UA-Robotics/UA-NASA-Robotic-Mining-2012-Hardware/Main Board V4.0/eagleUp/eagleUp_Main board V4.0_imagesize.png

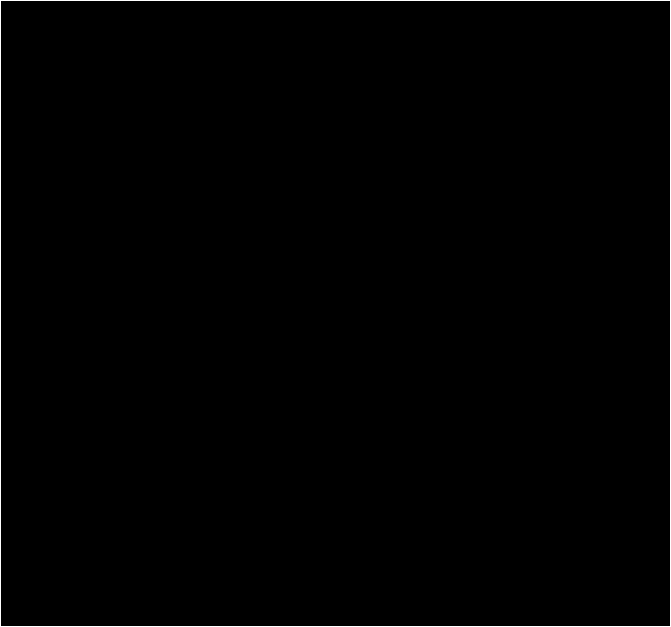
Main Board V4.0/eagleUp/eagleUp_Main board V4.0_imagesize.png
