UA-Robotics/UA-NASA-Robotic-Mining-2012-Hardware/Motor Control/eagleUp/eagleUp_Motor Control_board_top.png

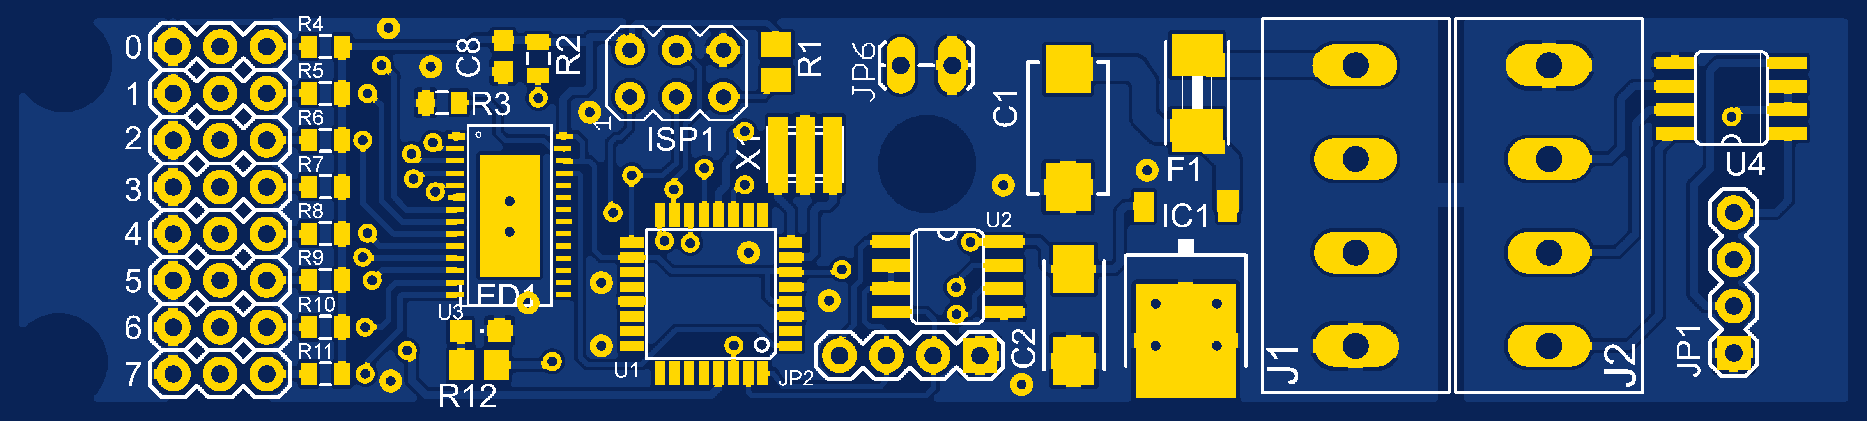
Motor Control/eagleUp/eagleUp_Motor Control_board_top.png
