UA-Robotics/UA-NASA-Robotic-Mining-2012-Hardware/Motor Control/eagleUp/eagleUp_Motor Control_bottom.png

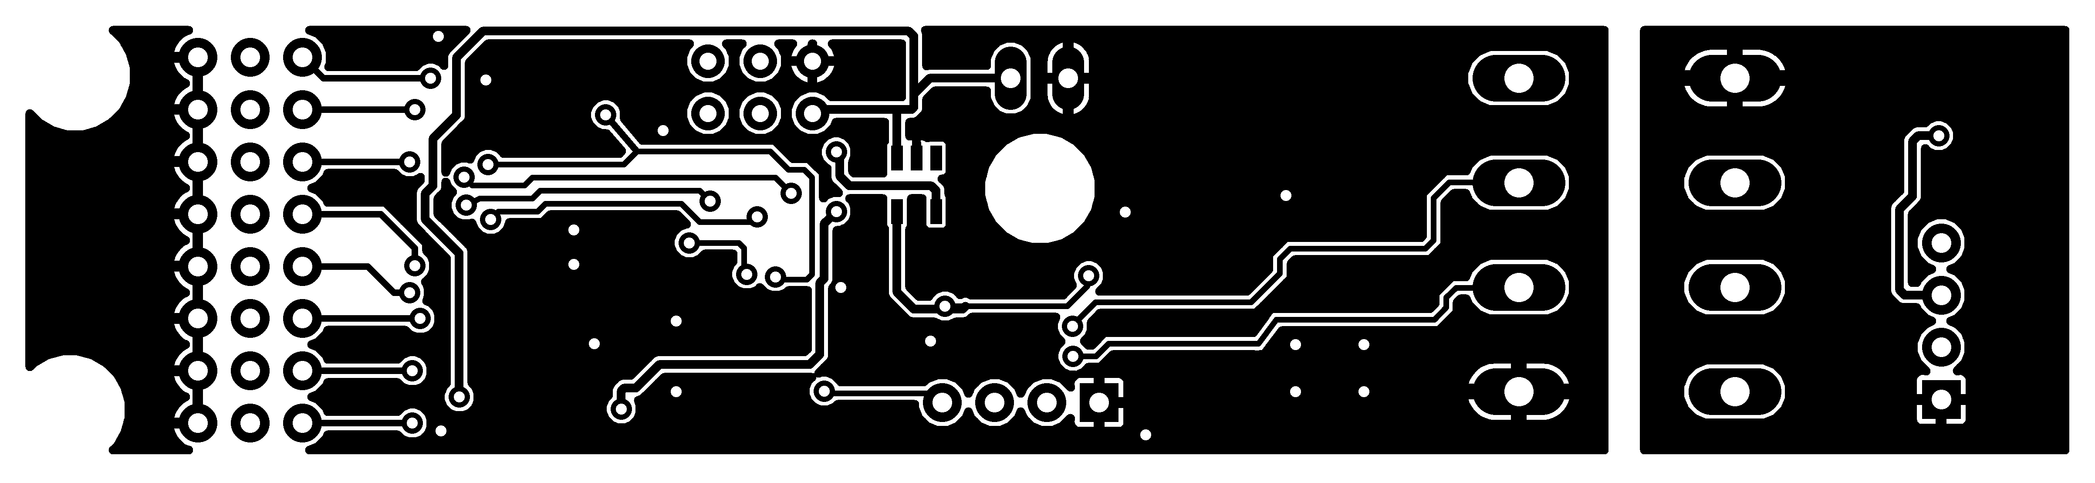
Motor Control/eagleUp/eagleUp_Motor Control_bottom.png
