UA-Robotics/UA-NASA-Robotic-Mining-2012-Hardware/Ext. Sens Board/nasa bot parts list per PCB.xlsx

 |  |  | ECE PARTS REQUEST ORDERING FORM
 |  | Student Name: | Richard Johnson | Email:
 |  | Project Name: | NASA Bot |  | Date Submitted:
 | Faculty Advisor Approval: |  |  |  | Date Ordered:
 |  | Email the completed form to: | glewis@uakron.edu |  | Ordered By:
 |  |  |  |  |  |  | Unit | Total
Qty. | Refdes | Part Num. | Description | Suggested Vendor | Vendor Part Num. | Catalog #/Page #/Website | Cost | Cost
2 |  | SK34B-TP | DIODE SCHOTTKY 3A 40V SMB | Digi-Key | SK34B-TPCT-ND | http://search.digikey.com/us/en/products/SK34B-TP/SK34B-TPCT-ND/950519 | 0.61 | 1.22
 |  |  |  |  |  |  |  | 0.00
 |  |  |  |  |  |  |  | 0.00
1 |  | MAX4080TASA | IC AMP CURRENT SENSE 8-SOIC | Digi-Key | MAX4080TASA+-ND | http://search.digikey.com/scripts/DkSearch/dksus.dll?Detail&name=MAX4080TASA%2B-ND | 2.78 | 2.78
 |  |  |  |  |  |  |  | 0.00
 |  |  |  |  |  |  |  | 0.00
 |  |  |  |  |  |  |  | 0.00
1 |  | ATMEGA1280-16AU | IC MCU AVR 128K FLASH 100-TQFP | Digi-Key | ATMEGA1280-16AU-ND | http://search.digikey.com/scripts/DkSearch/dksus.dll?Detail&name=ATMEGA1280-16AU-ND | 16.13 | 16.13
17 |  | ERJ-P06J103V | RES 10K OHM 5% 0805 | Digi-Key | P10KADCT-ND | http://search.digikey.com/scripts/DkSearch/dksus.dll?Detail&name=P10KADCT-ND | 0.23 | 3.91
6 |  | ERJ-P06J102V | RES ANTI-SURGE 1K OHM 5% 0805 | Digi-Key | P1.0KADCT-ND | http://search.digikey.com/scripts/DkSearch/dksus.dll?Detail&name=P1.0KADCT-ND | 0.23 | 1.38
 |  |  |  |  |  |  |  | 0.00
1 |  | 961206-6404-AR | CONN HEADER VERT DUAL 6POS GOLD | Digi-Key | 3M9459-ND | http://search.digikey.com/scripts/DkSearch/dksus.dll?Detail&name=3M9459-ND | 0.26 | 0.26
2 |  | FSM4JH | SWITCH TACT 6MM BLACK 160GF | Digi-Key | 450-1650-ND | http://search.digikey.com/scripts/DkSearch/dksus.dll?Detail&name=450-1650-ND | 0.13 | 0.26
2 |  | APT2012SGC | LED 2X1.2MM 568NM GN WTR CLR SMD | Digi-Key | 754-1131-1-ND | http://search.digikey.com/scripts/DkSearch/dksus.dll?Detail&name=754-1131-1-ND | 0.13 | 0.26
2 |  | APT2012EC | LED 2X1.2MM 625NM RD WTR CLR SMD | Digi-Key | 754-1128-1-ND | http://search.digikey.com/scripts/DkSearch/dksus.dll?Detail&name=754-1128-1-ND | 0.13 | 0.26
1 |  | AWSCR-16.00CV-T | RESONATOR CER 16.00MHZ W/CAP SMD | Digi-Key | 535-10008-1-ND | http://search.digikey.com/scripts/DkSearch/dksus.dll?Detail&name=535-10008-1-ND | 0.45 | 0.45
4 |  | 08055A220JAT2A | CAP CERM 22PF 5% 50V NP0 0805 (price per 10 (min 10)) | Digi-Key | 478-1308-1-ND | http://search.digikey.com/scripts/DkSearch/dksus.dll?Detail&name=478-1308-1-ND | 0.083 | 0.33
2 |  | UMK212F105ZG-T | CAP CER 1.0UF 50V Y5V 0805 | Digi-Key | 587-1308-1-ND | http://search.digikey.com/scripts/DkSearch/dksus.dll?Detail&name=587-1308-1-ND | 0.24 | 0.48
4 |  | C3216X5R1H106K | CAP CER 10UF 50V X5R 10% 1206 (price per 1(min 10)) | Digi-Key | 445-5998-1-ND | http://search.digikey.com/scripts/DkSearch/dksus.dll?Detail&name=445-5998-1-ND | 1.98 | 7.92
1 |  | C3216X5R1A107M | CAP CER 100UF 10V X5R 20% 1206 (price per 1(min 10) | Digi-Key | 445-6007-1-ND | http://search.digikey.com/scripts/DkSearch/dksus.dll?Detail&name=445-6007-1-ND | 3.63 | 3.63
4 |  | GRM216F51C104ZA01D | CAP CER .1UF 16V Y5V 0805 (100nf) (price per 1(min 10)) | Digi-Key | 490-1734-1-ND | http://search.digikey.com/scripts/DkSearch/dksus.dll?Detail&name=490-1734-1-ND | 0.076 | 0.30
1 |  | EEF-CX0J101R | CAP 100UF 6.3V SPEC POLYMER SMD(2917 pack) | Digi-Key | PCE4278CT-ND | http://search.digikey.com/scripts/DkSearch/dksus.dll?Detail&name=PCE4278CT-ND | 1.92 | 1.92
1 |  | ERJ-6ENF4702V | RES 47.0K OHM 1/8W 1% 0805 SMD | Digi-Key | P47.0KCCT-ND | http://search.digikey.com/scripts/DkSearch/dksus.dll?Detail&name=P47.0KCCT-ND | 0.07 | 0.07
1 |  | ERJ-6ENF1003V | RES 100K OHM 1/8W 1% 0805 SMD | Digi-Key | P100KCCT-ND | http://search.digikey.com/scripts/DkSearch/dksus.dll?Detail&name=P100KCCT-ND | 0.07 | 0.07
1 |  | ERJ-6ENF6812V | RES 68.1K OHM 1/4W 1% 0805 SMD | Digi-Key | P68.1KCCT-ND | http://search.digikey.com/scripts/DkSearch/dksus.dll?Detail&name=P68.1KCCT-ND | 0.07 | 0.07
1 |  | ERJ-6ENF1182V | RES 11.8K OHM 1/8W 1% 0805 SMD | Digi-Key | P11.8KCCT-ND | http://search.digikey.com/scripts/DkSearch/dksus.dll?Detail&name=P11.8KCCT-ND | 0.04 | 0.04
1 |  | ERJ-6ENF1071V | RES 1.07K OHM 1/8W 1% 0805 SMD | Digi-Key | P1.07KCCT-ND | http://search.digikey.com/scripts/DkSearch/dksus.dll?Detail&name=P1.07KCCT-ND | 0.07 | 0.07
1 |  | ERJ-6ENF5601V | RES 5.60K OHM 1/8W 1% 0805 SMD | Digi-Key | P5.60KCCT-ND | http://search.digikey.com/scripts/DkSearch/dksus.dll?Detail&name=P5.60KCCT-ND | 0.07 | 0.07
2 |  | ERJ-6ENF2201V | RES 2.20K OHM 1/8W 1% 0805 SMD | Digi-Key | P2.20KCCT-ND | http://search.digikey.com/scripts/DkSearch/dksus.dll?Detail&name=P2.20KCCT-ND | 0.07 | 0.14
2 |  | SMAJ60A | DIODE TVS 60V 400W UNI 5% SMA | Digi-Key | SMAJ60ALFCT-ND | http://search.digikey.com/us/en/products/SMAJ60A/SMAJ60ALFCT-ND/762524 |  | 0.00
2 |  | MAL214699113E3 | CAP ALUM 1200UF 50V 20% SMD | Digi-Key | 4446PHCT-ND | http://search.digikey.com/us/en/products/MAL214699113E3/4446PHCT-ND/2410469 |  | 0.00
1 |  | XP1001001-04R | Xport Rev. B11 | Mouser | 515-XP1001001-04R | http://www.mouser.com/Search/ProductDetail.aspx?qs=FyX%252bO5sUg7y%2FaLVJubNUCQ%3D%3D | 49 | 49.00
12 |  | 282825-2 | TERM BLOCK HDR 2POS VERT 5.08MM | Digi-Key | A98321-ND | http://search.digikey.com/scripts/DkSearch/dksus.dll?Detail&name=A98321-ND | 0.39 | 4.68
12 |  | 796634-2 | TERM BLOCK PLUG 2POS 5.08MM | Digi-Key | A98223-ND | http://search.digikey.com/scripts/DkSearch/dksus.dll?Detail&name=A98223-ND | 0.86 | 10.32
2 |  | MAX6818EAP+ | IC DEBOUNCER SWITCH OCTAL 20SSOP | Digi-Key | MAX6818EAP+-ND | http://search.digikey.com/scripts/DkSearch/dksus.dll?Detail&name=MAX6818EAP%2B-ND | 8.6 | 17.20
 |  |  |  |  |  |  |  | 0.00
 |  |  |  |  |  |  |  | 0.00
 |  |  |  |  |  |  |  | 0.00
 |  |  |  |  |  |  | Total | $123.23
