UA-Robotics/UA-NASA-Robotic-Mining-2012-Hardware/Main Board V4.0/Finnal nasa bot parts list per PCB.xlsx

 |  |  | ECE PARTS REQUEST ORDERING FORM
 |  | Student Name: | Richard Johnson | Email: | richcj10@gmail.com
 |  | Project Name: | NASA Bot |  | Date Submitted:
 | Faculty Advisor Approval: |  |  |  | Date Ordered:
 |  | Email the completed form to: | glewis@uakron.edu |  | Ordered By:
 |  |  |  |  |  |  | Unit | Total
Qty. | Refdes | Part Num. | Description | Suggested Vendor | Vendor Part Num. | Catalog #/Page #/Website | Cost | Cost
6 |  | ATMEGA1280-16AU | IC MCU AVR 128K FLASH 100-TQFP | Digi-Key | ATMEGA1280-16AU-ND | http://search.digikey.com/scripts/DkSearch/dksus.dll?Detail&name=ATMEGA1280-16AU-ND | $16.13 | $96.78
8 |  | ATMEGA328-AU | IC MCU AVR 32K FLASH 32TQFP | Digi-Key | ATMEGA328-AU-ND | http://search.digikey.com/us/en/products/ATMEGA328-AU/ATMEGA328-AU-ND/2271029 | $3.83 | $30.64
5 |  | CD74HC4067SM96 | IC MUX/DEMUX 1X16 24SSOP | Digi-Key | 296-9226-1-ND | http://search.digikey.com/us/en/products/CD74HC4067SM96/296-9226-1-ND/376978 | $0.91 | $4.55
9 |  | MAX6818EAP+ | IC DEBOUNCER SWITCH OCTAL 20SSOP | Digi-Key | MAX6818EAP+-ND | http://search.digikey.com/us/en/products/MAX6818EAP%2B/MAX6818EAP%2B-ND/774123 | $7.74 | $69.66
5 |  | MAX823SEUK+T | IC MPU SUPERVISORY CIRC SOT23-5 | Digi-Key | MAX823SEUK+TCT-ND | http://search.digikey.com/us/en/products/MAX823SEUK%2BT/MAX823SEUK%2BTCT-ND/774159 | $2.97 | $14.85
8 |  | MAX485CSA+ | IC TXRX RS485/RS422 LOWPWR 8SOIC | Digi-Key | MAX485CSA+-ND | http://search.digikey.com/us/en/products/MAX485CSA%2B/MAX485CSA%2B-ND/948027 | $2.89 | $23.12
12 |  | AWSCR-16.00MTD-T | RESONATOR CER 16.00MHZ W/CAP SMD | Digi-Key | 535-9362-1-ND | http://search.digikey.com/us/en/products/AWSCR-16.00MTD-T/535-9362-1-ND/675774 | $0.49 | $5.88
6 |  | LM2576S-5.0/NOPB | IC BUCK 5V 3A TO263-5 | Digi-Key | LM2576S-5.0-ND | http://search.digikey.com/us/en/products/LM2576S-5.0%2FNOPB/LM2576S-5.0-ND/363654 | $2.83 | $16.98
6 |  | LM2576S-12/NOPB | IC BUCK 12V 3A TO263-5 | Digi-Key | LM2576S-12-ND | http://search.digikey.com/us/en/products/LM2576S-12%2FNOPB/LM2576S-12-ND/363651 | $2.83 | $16.98
10 |  | MBRS340TRPBF | DIODE SCHOTTKY 40V 3A SMC | Digi-Key | MBRS340TRPBFCT-ND | http://search.digikey.com/us/en/products/MBRS340TRPBF/MBRS340TRPBFCT-ND/2687969 | $0.81 | $8.10
10 |  | 7447709101 | INDUCTOR POWER 100UH 2.5A SMD | Digi-Key | 732-1248-1-ND | http://search.digikey.com/us/en/products/7447709101/732-1248-1-ND/1639309 | $2.63 | $26.30
6 |  | AP1086D33G-13 | IC REG LDO 1.5A 3.3V TO252-3 | Digi-Key | AP1086D33GDICT-ND | http://search.digikey.com/us/en/products/AP1086D33G-13/AP1086D33GDICT-ND/1964712 | $1.25 | $7.50
5 |  | MAX4080SASA+ | IC AMP CURRENT SENSE 8-SOIC | Digi-Key | MAX4080SASA+-ND | http://search.digikey.com/us/en/products/MAX4080SASA%2B/MAX4080SASA%2B-ND/1702405 | $2.50 | $12.50
4 |  | MAL214699113E3 | CAP ALUM 1200UF 50V 20% SMD | Digi-Key | 4446PHCT-ND | http://search.digikey.com/us/en/products/MAL214699113E3/4446PHCT-ND/2410469 | $7.97 | $31.88
10 |  | MAL214699605E3 | CAP ALUM 1000UF 25V 20% SMD | Digi-Key | 4419PHCT-ND | http://search.digikey.com/us/en/products/MAL214699605E3/4419PHCT-ND/2410442 | $4.46 | $44.60
30 |  | GRM21BR71H104KA01L | CAP CER 0.1UF 50V 10% X7R 0805 | Digi-Key | 490-1666-1-ND | http://search.digikey.com/us/en/products/GRM21BR71H104KA01L/490-1666-1-ND/587431 | $0.06 | $1.71
2 |  | MP1001000G-01 | WiFi / 802.11 Modules MatchPort b/g Module | Mouser | 515-MP1001000G-01 | http://www.mouser.com/ProductDetail/Lantronix/MP1001000G-01/?qs=sGAEpiMZZMsRr7brxAGoXYBnwzG7B6e4RBX72l82EKo%3d | $59.38 | $118.76
4 |  | TLA-6T118LF-T | TRANSFORMER LAN 10/100 TX | Digi-Key | 445-6796-1-ND | http://search.digikey.com/us/en/products/TLA-6T118LF-T/445-6796-1-ND/2523617 | $4.19 | $16.76
30 |  | 796634-3 | TERM BLOCK PLUG 3POS 5.08MM | Digi-Key | A98224-ND | http://search.digikey.com/us/en/products/796634-3/A98224-ND/1827083 | $2.16 | $64.80
30 |  | 282814-3 | TERM BLOCK HDR 3POS R/A 5.08MM | Digi-Key | A98066-ND | http://search.digikey.com/us/en/products/282814-3/A98066-ND/1826929 | $0.76 | $22.80
15 |  | 796644-4 | TERM BLOCK HEADER 4POS R/A 5MM | Digi-Key | A98064-ND | http://search.digikey.com/us/en/products/282811-4/A98064-ND/1826927 | $0.85 | $12.75
15 |  | 796640-4 | TERM BLOCK PLUG 4POS STACK 5MM | Digi-Key | A98243-ND | http://search.digikey.com/us/en/products/796640-4/A98243-ND/1827102 | $3.55 | $53.25
70 |  | 796634-2 | TERM BLOCK PLUG 2POS 5.08MM | Digi-Key | A98223-ND | http://search.digikey.com/us/en/products/796634-2/A98223-ND/1827082 | $1.19 | $83.30
70 |  | 282814-2 | TERM BLOCK HDR 2POS R/A 5.08MM | Digi-Key | A98065-ND | http://search.digikey.com/us/en/products/282814-2/A98065-ND/1826928 | $0.59 | $41.30
14 |  | 961206-6404-AR | CONN HEADER VERT DUAL 6POS GOLD | Digi-Key | 3M9459-ND | http://search.digikey.com/us/en/products/961206-6404-AR/3M9459-ND/2071500 | $0.33 | $4.62
6 |  | RW3R5EAR100JE | RES POWER .100 OHM 3.5W 5% SMT | Digi-Key | RW3R5EAR100JE-ND | http://search.digikey.com/us/en/products/RW3R5EAR100JE/RW3R5EAR100JE-ND/824182 | $2.55 | $15.30
10 |  | RC0805JR-0747KL | RES 47K OHM 1/8W 5% 0805 SMD | Digi-Key | 311-47KARCT-ND | http://search.digikey.com/us/en/products/RC0805JR-0747KL/311-47KARCT-ND/731283 | $0.02 | $0.17
10 |  | RC0805JR-0791KL | RES 91K OHM 1/8W 5% 0805 SMD | Digi-Key | 311-91KARCT-ND | http://search.digikey.com/us/en/products/RC0805JR-0791KL/311-91KARCT-ND/731332 | $0.02 | $0.17
10 |  | RC0805JR-0724KL | RES 24K OHM 1/8W 5% 0805 SMD | Digi-Key | 311-24KARCT-ND | http://search.digikey.com/us/en/products/RC0805JR-0724KL/311-24KARCT-ND/731237 | $0.02 | $0.17
10 |  | RC0805JR-0718KL | RES 18K OHM 1/8W 5% 0805 SMD | Digi-Key | 311-18KARCT-ND | http://search.digikey.com/us/en/products/RC0805JR-0718KL/311-18KARCT-ND/731213 | $0.02 | $0.17
10 |  | RC0805JR-0713KL | RES 13K OHM 1/8W 5% 0805 SMD | Digi-Key | 311-13KARCT-ND | http://search.digikey.com/us/en/products/RC0805JR-0713KL/311-13KARCT-ND/731201 | $0.02 | $0.17
20 |  | RC0805JR-0710KL | RES 10K OHM 1/8W 5% 0805 SMD | Digi-Key | 311-10KARCT-ND | http://search.digikey.com/us/en/products/RC0805JR-0710KL/311-10KARCT-ND/731188 | $0.02 | $0.34
10 |  | RC0805JR-072K2L | RES 2.2K OHM 1/8W 5% 0805 SMD | Digi-Key | 311-2.2KARCT-ND | http://search.digikey.com/us/en/products/RC0805JR-072K2L/311-2.2KARCT-ND/731218 | $0.02 | $0.17
40 |  | RC0805JR-071KL | RES 1.0K OHM 1/8W 5% 0805 SMD | Digi-Key | 311-1.0KARCT-ND | http://search.digikey.com/us/en/products/RC0805JR-071KL/311-1.0KARCT-ND/731165 | $0.02 | $0.68
20 |  | RC0805FR-07182RL | RES 182 OHM 1/8W 1% 0805 SMD | Digi-Key | 311-182CRCT-ND | http://search.digikey.com/us/en/products/RC0805FR-07182RL/311-182CRCT-ND/730598 | $0.02 | $0.40
10 |  | RC0805FR-0775RL | RES 75.0 OHM 1/8W 1% 0805 SMD | Digi-Key | 311-75.0CRCT-ND | http://search.digikey.com/us/en/products/RC0805FR-0775RL/311-75.0CRCT-ND/731079 | $0.02 | $0.20
10 |  | RJ0805FRE0710RL | RES 10 OHM 1/10W 1% 0805 SMD | Digi-Key | 311-10VCT-ND | http://search.digikey.com/us/en/products/RJ0805FRE0710RL/311-10VCT-ND/1037168 | $0.06 | $0.64
30 |  | LTST-C171GKT | LED GREEN CLEAR THIN 0805 SMD | Digi-Key | 160-1423-1-ND | http://search.digikey.com/us/en/products/LTST-C171GKT/160-1423-1-ND/386792 | $0.45 | $13.50
12 |  | LTST-C171AKT | LED AMBER CLR THIN 0805 SMD | Digi-Key | 160-1419-1-ND | http://search.digikey.com/us/en/products/LTST-C171AKT/160-1419-1-ND/386784 | $0.50 | $6.00
8 |  | LTST-C171TBKT | LED 468NM BLUE CLEAR 0805 SMD | Digi-Key | 160-1645-1-ND | http://search.digikey.com/us/en/products/LTST-C171TBKT/160-1645-1-ND/573585 | $0.48 | $3.84
8 |  | SML-LXT0805IW-TR | LED THIN 635NM RED DIFF 0805 SMD | Digi-Key | 67-1552-1-ND | http://search.digikey.com/us/en/products/SML-LXT0805IW-TR/67-1552-1-ND/304366 | $0.38 | $3.04
2 |  | SMAJ28CA-TR | TRANSIL 400W 28V BIDIRECT SMA | Digi-Key | 497-4620-1-ND | http://search.digikey.com/us/en/products/SMAJ28CA-TR/497-4620-1-ND/806481 | $0.54 | $1.08
10 |  | EXC-ML16A270U | BEAD CORE 27 OHM 4A 0603 SMD | Digi-Key | P10436CT-ND | http://search.digikey.com/us/en/products/EXC-ML16A270U/P10436CT-ND/268403 | $0.21 | $2.10
15 |  | 881545-2 | SHUNT LP W/HANDLE 2 POS 30AU | Digi-Key | A26242-ND | http://search.digikey.com/us/en/products/881545-2/A26242-ND/290572 | $0.21 | $3.19
16 |  | 950510-6102-AR | CONN SOCKET 10POS 2MM VERT T/H | Digi-Key | 3M9405-ND | http://search.digikey.com/us/en/products/950510-6102-AR/3M9405-ND/1959133 | $1.62 | $25.92
8 |  | SSA12 | SWITCH SLIDE SPDT 2POS SSA SER | Digi-Key | 450-1602-ND | http://search.digikey.com/us/en/products/SSA12/450-1602-ND/1201305 | $1.81 | $14.48
25 |  | UMK212B7105KG-T | CAP CER 1UF 50V 10% X7R 0805 | Digi-Key | 587-2910-1-ND | http://search.digikey.com/us/en/products/UMK212B7105KG-T/587-2910-1-ND/2649030 | $0.39 | $9.75
25 |  | LMK212SD104KG-T | CAP CER 0.1UF 10V 10% 0805 | Digi-Key | 587-1134-1-ND | http://search.digikey.com/us/en/products/LMK212SD104KG-T/587-1134-1-ND/930911 | $0.45 | $11.25
6 |  | GRM21BR71H104KA01L | CAP CER 0.1UF 50V 10% X7R 0805 | Digi-Key | 490-1666-1-ND | http://search.digikey.com/us/en/products/GRM21BR71H104KA01L/490-1666-1-ND/587431 | $0.06 | $0.34
6 |  | VJ1812Y102KXEAT5Z | CAP CER 1000PF 500V 10% X7R 1812 | Digi-Key | 720-1001-1-ND | http://search.digikey.com/us/en/products/VJ1812Y102KXEAT5Z/720-1001-1-ND/1560003 | $1.76 | $10.56
6 |  | GQM2195C1H220JB01D | CAP CER 22PF 50V 5% NP0 0805 | Digi-Key | 490-3608-1-ND | http://search.digikey.com/us/en/products/GQM2195C1H220JB01D/490-3608-1-ND/789608 | $0.50 | $3.00
15 |  | EMK212BJ106KG-T | CAP CER 10UF 16V 10% X5R 0805 | Digi-Key | 587-1295-1-ND | http://search.digikey.com/us/en/products/EMK212BJ106KG-T/587-1295-1-ND/931072 | $0.42 | $6.30
20 |  | T491A106M016AT | CAP TANT 10UF 16V 20% 1206 | Digi-Key | 399-3687-1-ND | http://search.digikey.com/us/en/products/T491A106M016AT/399-3687-1-ND/819012 | $0.54 | $10.80
20 |  | 4-103741-0 | CONN HDR BRKWAY .100 40POS VERT | Digi-Key | A26509-40-ND | http://search.digikey.com/us/en/products/4-103741-0/A26509-40-ND/297917 | $1.90 | $38.00
50 |  | 103688-1 | CONN RECEPTACLE 2POS .1" UNLOAD | Digi-Key | A28352-ND | http://search.digikey.com/us/en/products/103688-1/A28352-ND/298629 | $0.58 | $29.00
100 |  | 1-104479-0 | CONN SOCKET 20-24AWG 30AU CRIMP | Digi-Key | A34249CT-ND | http://search.digikey.com/us/en/products/1-104479-0/A34249CT-ND/1126747 | $0.11 | $10.91
2 |  | 4808-3004-CP | SOCKET IC OPEN FRAME 8POS .3" | Digi-Key | 3M5473-ND | http://search.digikey.com/us/en/products/4808-3004-CP/3M5473-ND/1133626 | $0.29 | $0.58
4 |  | UX60-MB-5ST | CONN RECEPT MINI USB2.0 5POS | Digi-Key | H2959CT-ND | http://search.digikey.com/us/en/products/UX60-MB-5ST/H2959CT-ND/597538 | $1.25 | $5.00
2 |  | 87499-7 | CONN HOUSING 4POS .100 SINGLE | Digi-Key | A3013-ND | http://search.digikey.com/us/en/products/87499-7/A3013-ND/29911 | $0.63 | $1.26
25 |  | 2-87195-6 | CONN SOCKET 20-24AWG CRIMP GOLD | Digi-Key | 2-87195-6-ND | http://search.digikey.com/us/en/products/2-87195-6/2-87195-6-ND/2259118 | $0.42 | $10.50
2 |  | 102241-6 | CONN HOUSING 8POS .100 POLAR | Digi-Key | A26987-ND | http://search.digikey.com/us/en/products/102241-6/A26987-ND/289369 | $0.78 | $1.56
 |  |  |  |  |  |  | Total | 1070.92
