UA-Robotics/UA-NASA-Robotic-Mining-2012-Hardware/Motor Control/Motor Control Parts Request form.xlsx

 |  |  | ECE PARTS REQUEST ORDERING FORM
 |  | Student Name: | Richard Johnson | Email:
 |  | Project Name: | NASA Bot |  | Date Submitted:
 | Faculty Advisor Approval: |  |  |  | Date Ordered:
 |  | Email the completed form to: | glewis@uakron.edu |  | Ordered By:
 |  |  |  |  |  |  | Unit | Total
Qty. | Refdes | Part Num. | Description | Suggested Vendor | Vendor Part Num. | Catalog #/Page #/Website | Cost | Cost
2 |  | ATMEGA328-AU | IC MCU AVR 32K FLASH 32TQFP | Digi-Key | ATMEGA328-AU-ND | http://search.digikey.com/us/en/products/ATMEGA328-AU/ATMEGA328-AU-ND/2271029 | 3.83 | 7.66 | 2
2 |  | AWSCR-16.00MTD-T | RESONATOR CER 16.00MHZ W/CAP SMD | Digi-Key | 535-9362-1-ND | http://search.digikey.com/us/en/products/AWSCR-16.00MTD-T/535-9362-1-ND/675774 | 0.49 | 0.98 | 2
2 |  | L7805CDT-TR | IC REG POS 1.5A 5V PREC DPAK | Digi-key | 497-7255-1-ND | http://search.digikey.com/us/en/products/L7805CDT-TR/497-7255-1-ND/1884014 | 0.85 | 0.11
2 |  | TLC5940PWP | IC LED DRVR PWM CONTROL 28-TSSOP | Digi-Key | 296-17733-5-ND | http://search.digikey.com/us/en/products/TLC5940PWP/296-17733-5-ND/716897 | 4.2 | 1.70 | 2
3 |  | MAX485CSA+ | IC TXRX RS485/RS422 LOWPWR 8SOIC | Digi-Key | MAX485CSA+-ND | http://search.digikey.com/us/en/products/MAX485CSA%2B/MAX485CSA%2B-ND/948027 | 2.89 | 8.40 | 3
4 |  | ERJ-6GEYJ103V | RES 10K OHM 1/8W 5% 0805 SMD | Digi-Key | P10KACT-ND | http://search.digikey.com/us/en/products/ERJ-6GEYJ103V/P10KACT-ND/43118 | 0.04 | 2.16 | 4
2 |  | ERJ-6GEYJ102V | RES 1.0K OHM 1/8W 5% 0805 SMD | Digi-Key | P1.0KACT-ND | http://search.digikey.com/us/en/products/ERJ-6GEYJ102V/P1.0KACT-ND/42833 | 0.04 | 0.72 | 2
18 |  | ERJ-6GEYJ222V | RES 2.2K OHM 1/8W 5% 0805 SMD | Digi-Key | P2.2KACT-ND | http://search.digikey.com/us/en/products/ERJ-6GEYJ222V/P2.2KACT-ND/93214 | 0.04 | 8.67 | 18
2 |  | GRM21BR71H104KA01L | CAP CER 0.1UF 50V 10% X7R 0805 | Digi-Key | 490-1666-1-ND | http://search.digikey.com/us/en/products/GRM21BR71H104KA01L/490-1666-1-ND/587431 | 0.057 | 0.16 | 10
4 |  | T491C106K025AT | CAP TANT 10UF 25V 10% 2312 | Digi-Key | 399-3734-1-ND | http://search.digikey.com/us/en/products/T491C106K025AT/399-3734-1-ND/819059 | 0.54 | 0.08 | 4
2 |  | CMDA5DY7D1S | LED 595NM AMBER DIFF SMD 0805 | Digi-Key | L71517CT-ND | http://search.digikey.com/us/en/products/CMDA5DY7D1S/L71517CT-ND/614867 | 0.35 | 0.70 | 2
4 |  | 4-103741-0 | CONN HDR BRKWAY .100 40POS VERT | Digi-Key | A26509-40-ND | http://search.digikey.com/us/en/products/4-103741-0/A26509-40-ND/297917 | 1.9 | 7.60 | 4
2 |  | 1812L035/30DR | FUSE PTC RESET .35A 30V 1812 | Digi-Key | F4158CT-ND | http://search.digikey.com/us/en/products/1812L035%2F30DR/F4158CT-ND/2764692 | 0.67 | 1.34 | 2
2 |  | 961206-6404-AR | CONN HEADER VERT DUAL 6POS GOLD | Digi-Key | 3M9459-ND | http://search.digikey.com/us/en/products/961206-6404-AR/3M9459-ND/2071500 | 0.33 | 0.66 | 2
3 |  | 282811-4 | TERM BLOCK HEADER 4POS R/A 5MM | Digi-Key | A98064-ND | http://search.digikey.com/us/en/products/282811-4/A98064-ND/1826927 | 0.85 | 2.55
3 |  | 796640-4 | TERM BLOCK PLUG 4POS STACK 5MM | Digi-Key | A98243-ND | http://search.digikey.com/us/en/products/796640-4/A98243-ND/1827102 | 3.55 | 10.65
 |  |  |  |  |  |  |  | 0.00
 |  |  |  |  |  |  |  | 0.00
 |  |  |  |  |  |  |  | 0.00
 |  |  |  |  |  |  |  | 0.00
 |  |  |  |  |  |  |  | 0.00
 |  |  |  |  |  |  |  | 0.00
 |  |  |  |  |  |  |  | 0.00
 |  |  |  |  |  |  |  | 0.00
 |  |  |  |  |  |  |  | 0.00
 |  |  |  |  |  |  |  | 0.00
 |  |  |  |  |  |  |  | 0.00
 |  |  |  |  |  |  |  | 0.00
 |  |  |  |  |  |  |  | 0.00
 |  |  |  |  |  |  |  | 0.00
 |  |  |  |  |  |  |  | 0.00
 |  |  |  |  |  |  |  | 0.00
 |  |  |  |  |  |  |  | 0.00
 |  |  |  |  |  |  |  | 0.00
 |  |  |  |  |  |  |  | 0.00
 |  |  |  |  |  |  |  | 0.00
 |  |  |  |  |  |  |  | 0.00
 |  |  |  |  |  |  |  | 0.00
 |  |  |  |  |  |  |  | 0.00
 |  |  |  |  |  |  | Total | $54.14
