UA-Robotics/UA-NASA-Robotic-Mining-2012-Hardware/Ext. Sens Board/ECEparts request -ExtSens.xlsx

 |  |  | ECE PARTS REQUEST ORDERING FORM
 |  | Student Name: | Richard Johnson | Email:
 |  | Project Name: | NASA Lunabot |  | Date Submitted: | 2012-01-25
 | Faculty Advisor Approval: |  |  |  | Date Ordered:
 |  | Email the completed form to: | glewis@uakron.edu |  | Ordered By:
 |  |  |  |  |  |  | Unit | Total
Qty. | Refdes | Part Num. | Description | Suggested Vendor | Vendor Part Num. | Catalog #/Page #/Website | Cost | Cost
2 |  | T491A106M016AT | CAP TANT 10UF 16V | Digikey | 399-3687-1-ND | http://search.digikey.com/us/en/products/T491A106M016AT/399-3687-1-ND/819012 | 0.54 | 1.08
12 |  | GRM21BR71E104KA01L | CAP CER 0.1UF 25V | Digikey | 490-1673-1-ND | http://search.digikey.com/us/en/products/GRM21BR71E104KA01L/490-1673-1-ND/587412 | 0.188 | 2.26
4 |  | ERJ-6GEYJ751V | RES 750 OHM 1/8W | Digikey | P750ACT-ND | http://search.digikey.com/us/en/products/ERJ-6GEYJ751V/P750ACT-ND/90034 | 0.04 | 0.16
10 | need 2 per x 2 | GRM219F51E224ZA01D | CAP CER 0.22UF 25V Y5V 0805 | Digikey | 490-1728-1-ND | http://search.digikey.com/us/en/products/GRM219F51E224ZA01D/490-1728-1-ND/587610 | 0.22 | 2.20
2 |  | IDG500 | Integrated Dual-Axis Gyroscope | InvenSense | IDG500 | http://invensense.com/mems/gyro/idg500.html | 6 | 12.00
2 |  | HMC6352-TR | COMPASS DGTL 2AXIS | Digikey | 342-1041-1-ND | http://search.digikey.com/us/en/products/HMC6352-TR/342-1041-1-ND/603153 | 24 | 48.00
2 |  | ADXL335BCPZ-RL7 | ACCELEROMETER 3AXL 3G | Digikey | ADXL335BCPZ-RL7CT-ND | http://search.digikey.com/us/en/products/ADXL335BCPZ-RL7/ADXL335BCPZ-RL7CT-ND/1995485 | 6.9 | 13.80
2 |  | ADS7844E/2K5 | 12-BIT 8-CHANNEL A/D | Digikey | ADS7844ECT-ND | http://search.digikey.com/us/en/products/ADS7844E%2F2K5/ADS7844ECT-ND/2520761 | 7.31 | 14.62
1 |  | PPTC361LFBN-RC | CONN HEADER FEMALE 36POS.1" | Digikey | S7034-ND | http://search.digikey.com/us/en/products/PPTC361LFBN-RC/S7034-ND/810173 | 2.32 | 2.32
 |  |  |  |  |  |  |  | 0.00
 |  |  |  |  |  |  |  | 0.00
 |  |  |  |  |  |  |  | 0.00
 |  |  |  |  |  |  |  | 0.00
 |  |  |  |  |  |  |  | 0.00
 |  |  |  |  |  |  |  | 0.00
 |  |  |  |  |  |  |  | 0.00
 |  |  |  |  |  |  |  | 0.00
 |  |  |  |  |  |  |  | 0.00
 |  |  |  |  |  |  |  | 0.00
 |  |  |  |  |  |  |  | 0.00
 |  |  |  |  |  |  |  | 0.00
 |  |  |  |  |  |  |  | 0.00
 |  |  |  |  |  |  |  | 0.00
 |  |  |  |  |  |  |  | 0.00
 |  |  |  |  |  |  |  | 0.00
 |  |  |  |  |  |  |  | 0.00
 |  |  |  |  |  |  |  | 0.00
 |  |  |  |  |  |  |  | 0.00
 |  |  |  |  |  |  |  | 0.00
 |  |  |  |  |  |  |  | 0.00
 |  |  |  |  |  |  |  | 0.00
 |  |  |  |  |  |  |  | 0.00
 |  |  |  |  |  |  | Total | $96.44
