UA-Robotics/UA-NASA-Robotic-Mining-2012-Hardware/LIDAR/ECEparts request -LIDAR.xlsx

 |  |  | ECE PARTS REQUEST ORDERING FORM
 |  | Student Name: | Richard Johnson | Email:
 |  | Project Name: | NASA Lunabot |  | Date Submitted:
 | Faculty Advisor Approval: |  |  |  | Date Ordered:
 |  | Email the completed form to: | glewis@uakron.edu |  | Ordered By:
 |  |  |  |  |  |  | Unit | Total
Qty. | Refdes | Part Num. | Description | Suggested Vendor | Vendor Part Num. | Catalog #/Page #/Website | Cost | Cost
4 |  | 440054-4 | CONN HEADER 4POS 2MM VERT | Digikey | A100036-ND | http://search.digikey.com/us/en/products/440054-4/A100036-ND/2077941?wt.mc_id=Dxn_US_US2010_Catlink | 0.28 | 1.12
4 |  | 440054-2 | CONN HEADER 2POS 2MM VERT | Digikey | A100034-ND | http://search.digikey.com/us/en/products/440054-2/A100034-ND/2077939?wt.mc_id=Dxn_US_US2010_Catlink | 0.11 | 0.44
4 |  | ATMEGA644P-20AU | IC MCU AVR 64K FLASH 44-TQFP | Digikey | ATMEGA644P-20AU-ND | http://search.digikey.com/us/en/products/ATMEGA644P-20AU/ATMEGA644P-20AU-ND/1245864 | 8.08 | 32.32
8 |  | T491A106M016AT | CAP TANT 10UF 16V | Digikey | 399-3687-1-ND | http://search.digikey.com/us/en/products/T491A106M016AT/399-3687-1-ND/819012 | 0.54 | 4.32
4 |  | T491C106K025AT | CAP TANT 10UF 25V | Digikey | 399-3734-1-ND | http://search.digikey.com/us/en/products/T491C106K025AT/399-3734-1-ND/819059 | 0.79 | 3.16
4 |  | 0ZCA0020FF2E | PTC RESTTBLE 0.20A 30V | Digikey | 507-1478-1-ND | http://search.digikey.com/us/en/products/0ZCA0020FF2E/507-1478-1-ND/2165307 | 0.28 | 1.12
20 |  | GRM21BR71E104KA01L | CAP CER 0.1UF 25V | Digikey | 490-1673-1-ND | http://search.digikey.com/us/en/products/GRM21BR71E104KA01L/490-1673-1-ND/587412 | 0.188 | 3.76
12 |  | ERJ-6GEYJ102V | RES 1.0K OHM 1/8W | Digikey | P1.0KACT-ND | http://search.digikey.com/us/en/products/ERJ-6GEYJ102V/P1.0KACT-ND/42833 | 0.04 | 0.48
4 |  | ERJ-6GEYJ103V | RES 10K OHM 1/8W | Digikey | P10KACT-ND | http://search.digikey.com/us/en/products/ERJ-6GEYJ103V/P10KACT-ND/43118 | 0.04 | 0.16
4 |  | LTST-C191KGKT | LED GREEN CLEAR THIN 0603 SMD | Digikey | 160-1446-1-ND | http://search.digikey.com/us/en/products/LTST-C191KGKT/160-1446-1-ND/386834 | 0.45 | 1.80
4 |  | LTST-C190KRKT | LED SUPER RED CLEAR 0603 | Digikey | 160-1436-1-ND | http://search.digikey.com/us/en/products/LTST-C190KRKT/160-1436-1-ND/386816 | 0.41 | 1.64
4 |  | LTST-C190KYKT | LED AMBER YELLOW CLEAR 0603 | Digikey | 160-1438-1-ND | http://search.digikey.com/us/en/products/LTST-C190KYKT/160-1438-1-ND/386820 | 0.46 | 1.84
4 |  | MAX485CSA+ | IC TXRX RS485/RS422 LOWPWR 8SOIC | Digikey | MAX485CSA+-ND | http://search.digikey.com/us/en/products/MAX485CSA%2B/MAX485CSA%2B-ND/948027 | 2.89 | 11.56
4 |  | EVQ-PF008K | SWITCH TACTILE SPST-NO | Digikey | P10880S-ND | http://search.digikey.com/scripts/DkSearch/dksus.dll?WT.z_header=search_go&lang=en&site=us&x=0&y=0 | 0.29 | 1.16
20 |  | 1547E | STANDOFF RND 4-40THR BR 1.00"L | Digikey | 1547EK-ND | http://search.digikey.com/us/en/products/1547E/1547EK-ND/303619 | 1.197 | 23.94
1 |  | uLCD43 | Serial TFT LCD 4.3" with Touchscreen | Sparkfun | LCD-11075 | http://www.sparkfun.com/products/11075 | 139.95 | 139.95
4 |  | BlinkM MaxM | I2C Controlled RGB LED | Sparkfun | COM-09000 | http://www.sparkfun.com/products/9000 | 24.95 | 99.80
1 |  | N/A | Metal Pushbutton with Red LED Ring -NO | Adafruit | 559 | https://www.adafruit.com/products/559 | 5.95 | 5.95
 |  |  |  |  |  |  |  | 0.00
 |  |  |  |  |  |  |  | 0.00
 |  |  |  |  |  |  |  | 0.00
 |  |  |  |  |  |  |  | 0.00
 |  |  |  |  |  |  |  | 0.00
 |  |  |  |  |  |  |  | 0.00
 |  |  |  |  |  |  |  | 0.00
 |  |  |  |  |  |  |  | 0.00
 |  |  |  |  |  |  |  | 0.00
 |  |  |  |  |  |  |  | 0.00
 |  |  |  |  |  |  |  | 0.00
 |  |  |  |  |  |  |  | 0.00
 |  |  |  |  |  |  |  | 0.00
 |  |  |  |  |  |  |  | 0.00
 |  |  |  |  |  |  |  | 0.00
 |  |  |  |  |  |  |  | 0.00
 |  |  |  |  |  |  |  | 0.00
 |  |  |  |  |  |  |  | 0.00
 |  |  |  |  |  |  |  | 0.00
 |  |  |  |  |  |  |  | 0.00
 |  |  |  |  |  |  |  | 0.00
 |  |  |  |  |  |  |  | 0.00
 |  |  |  |  |  |  | Total | $334.52
