UA-Robotics/UA-NASA-Robotic-Mining-2012-Hardware/Main Board V4.0/Main board V4.0BRD.pdf

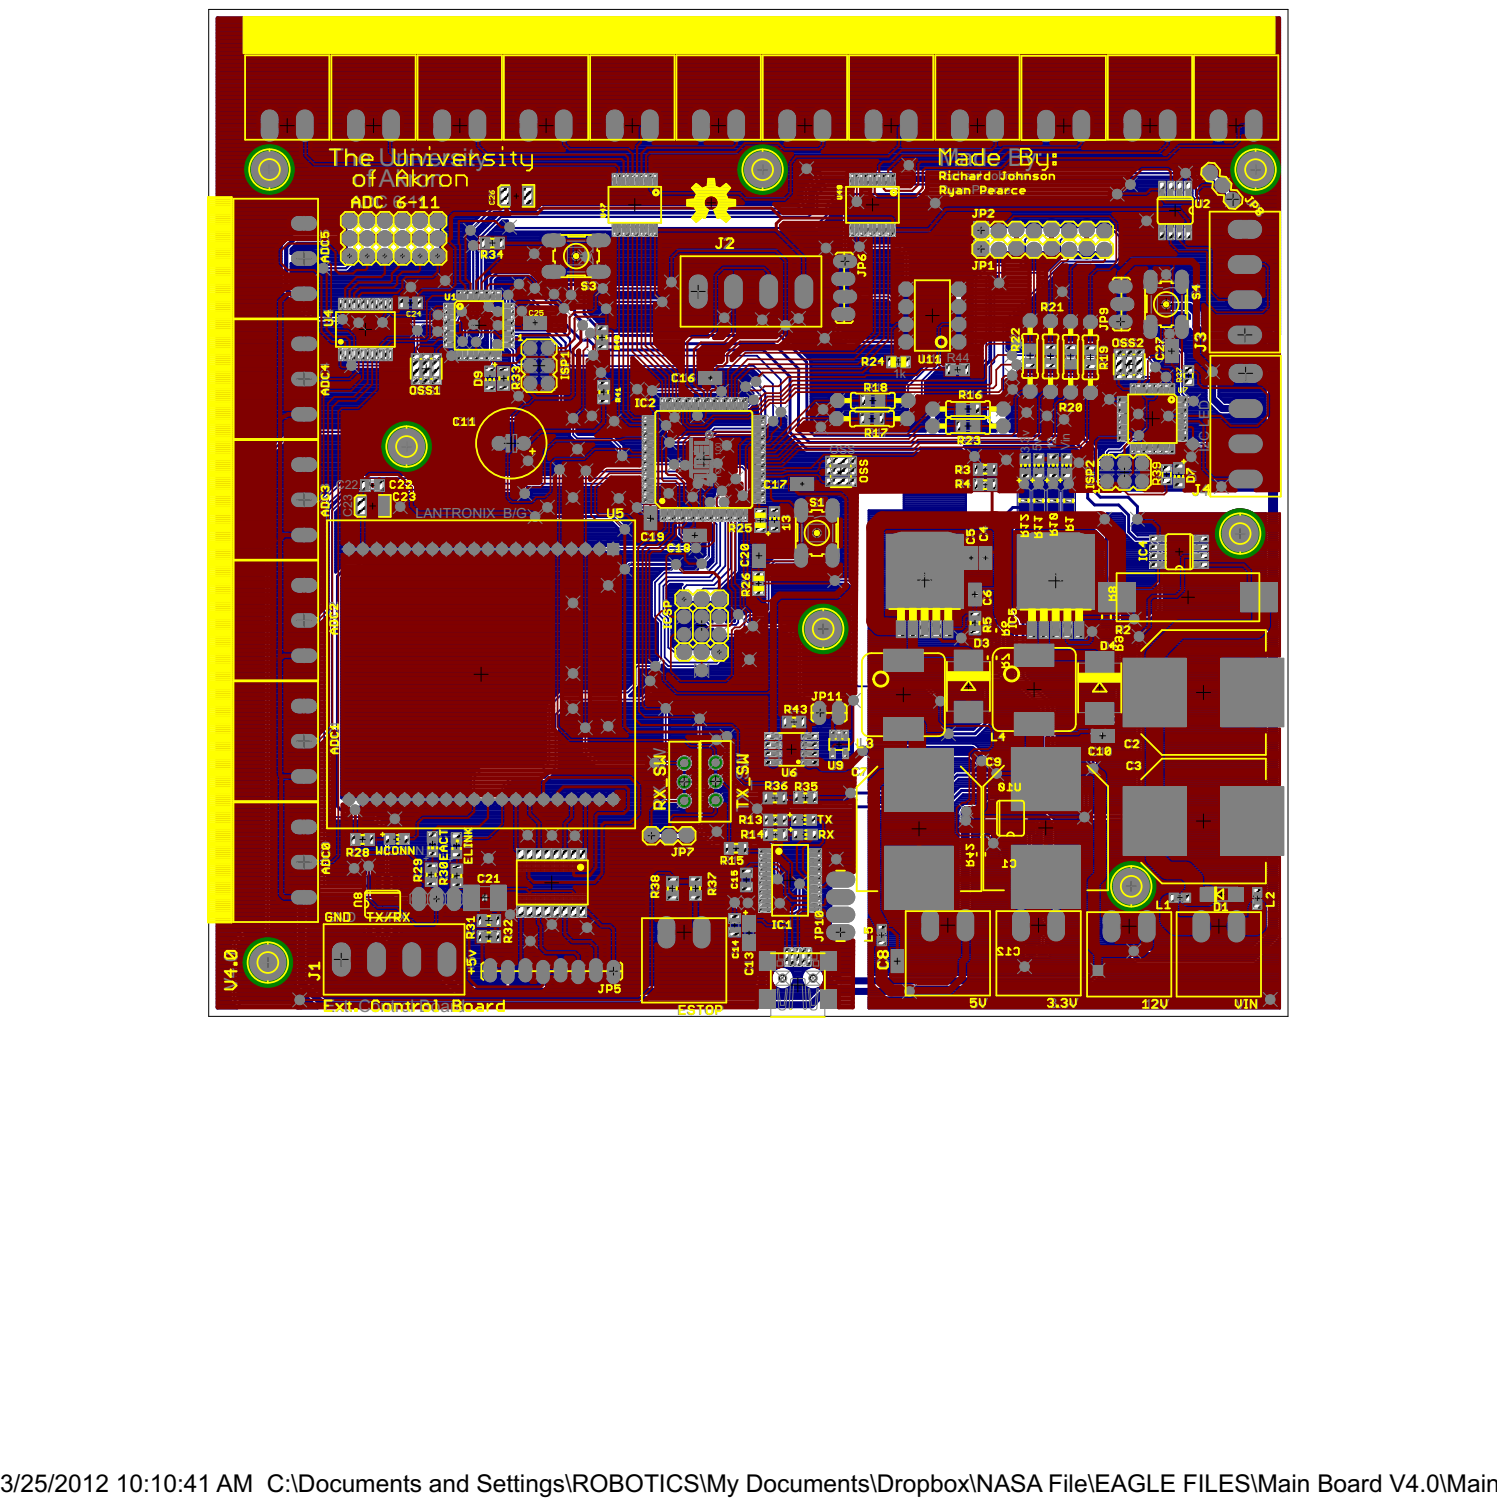
[picture p19: page 1]

Richard Johnson Ryan Pearce

3/25/2012 10:10:41 AM C:\Documents and Settings\ROBOTICS\My Documents\Dropbox\NASA File\EAGLE FILES\Main Board V4.0\Main board V4.0.brd
