UA-Robotics/UA-NASA-Robotic-Mining-2012-Hardware/Main Board V4.0/Main board V4.0SCH.pdf

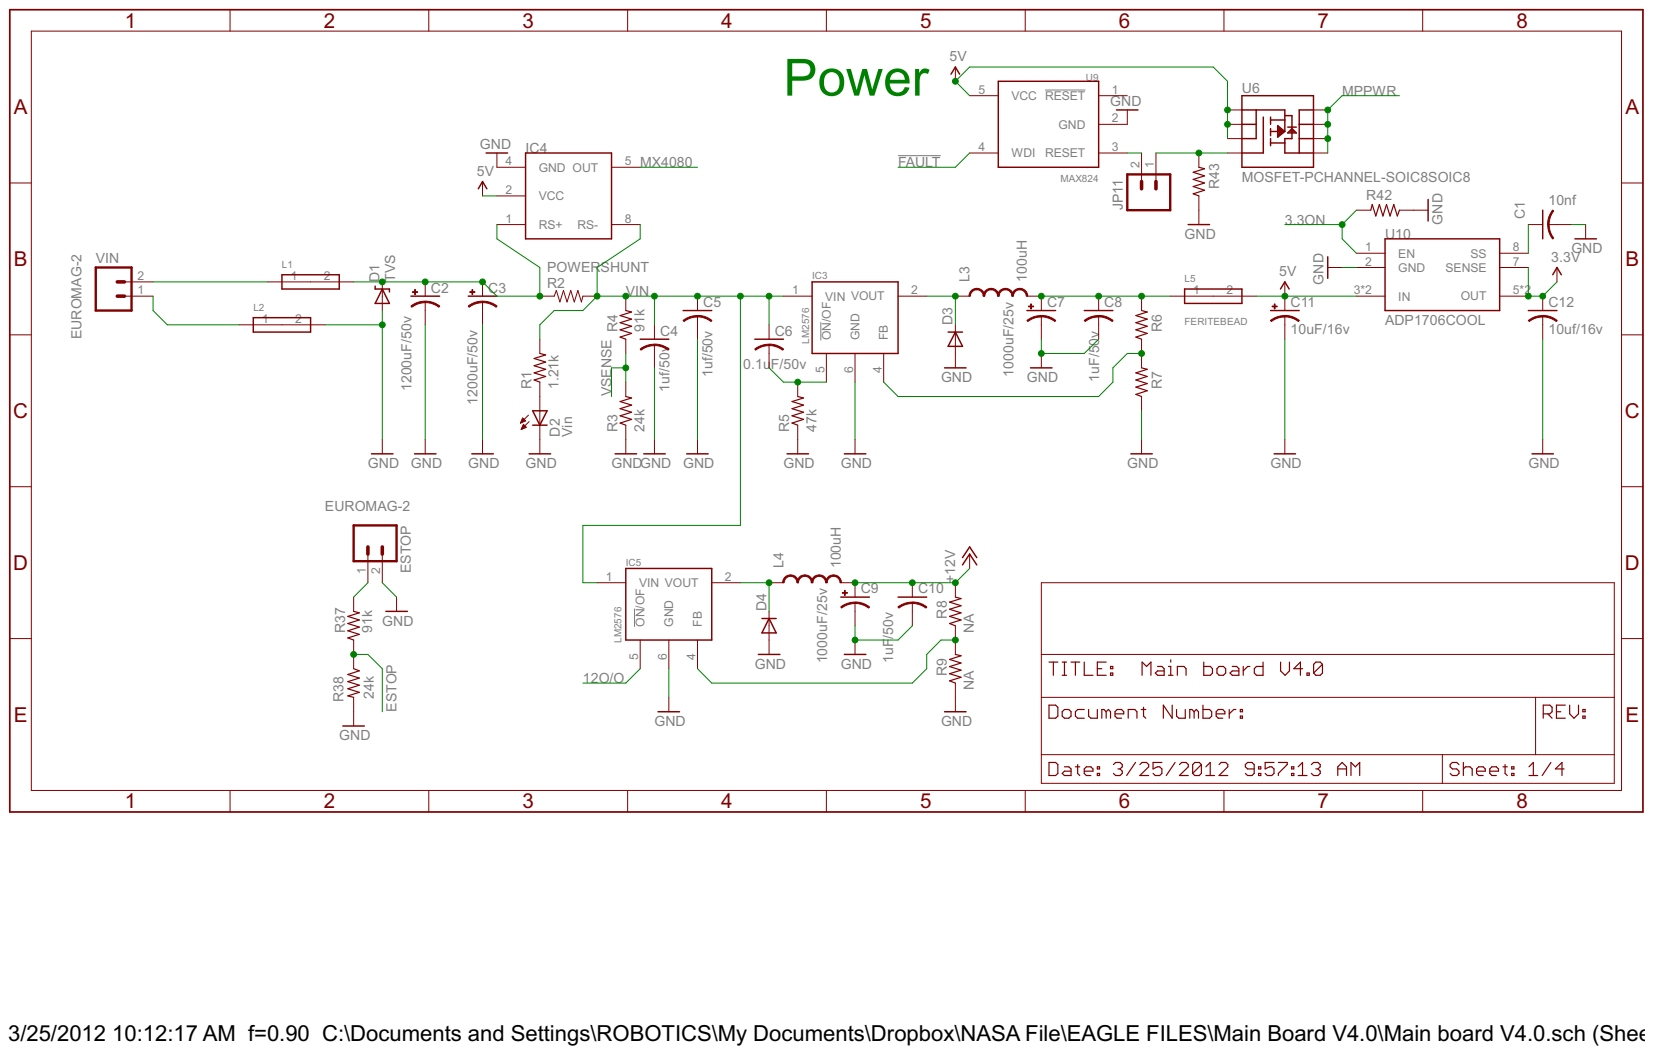
[picture p20: page 1]

3/25/2012 10:12:17 AM f=0.90 C:\Documents and Settings\ROBOTICS\My Documents\Dropbox\NASA File\EAGLE FILES\Main Board V4.0\Main board V4.0.sch (Sheet: 1/4)

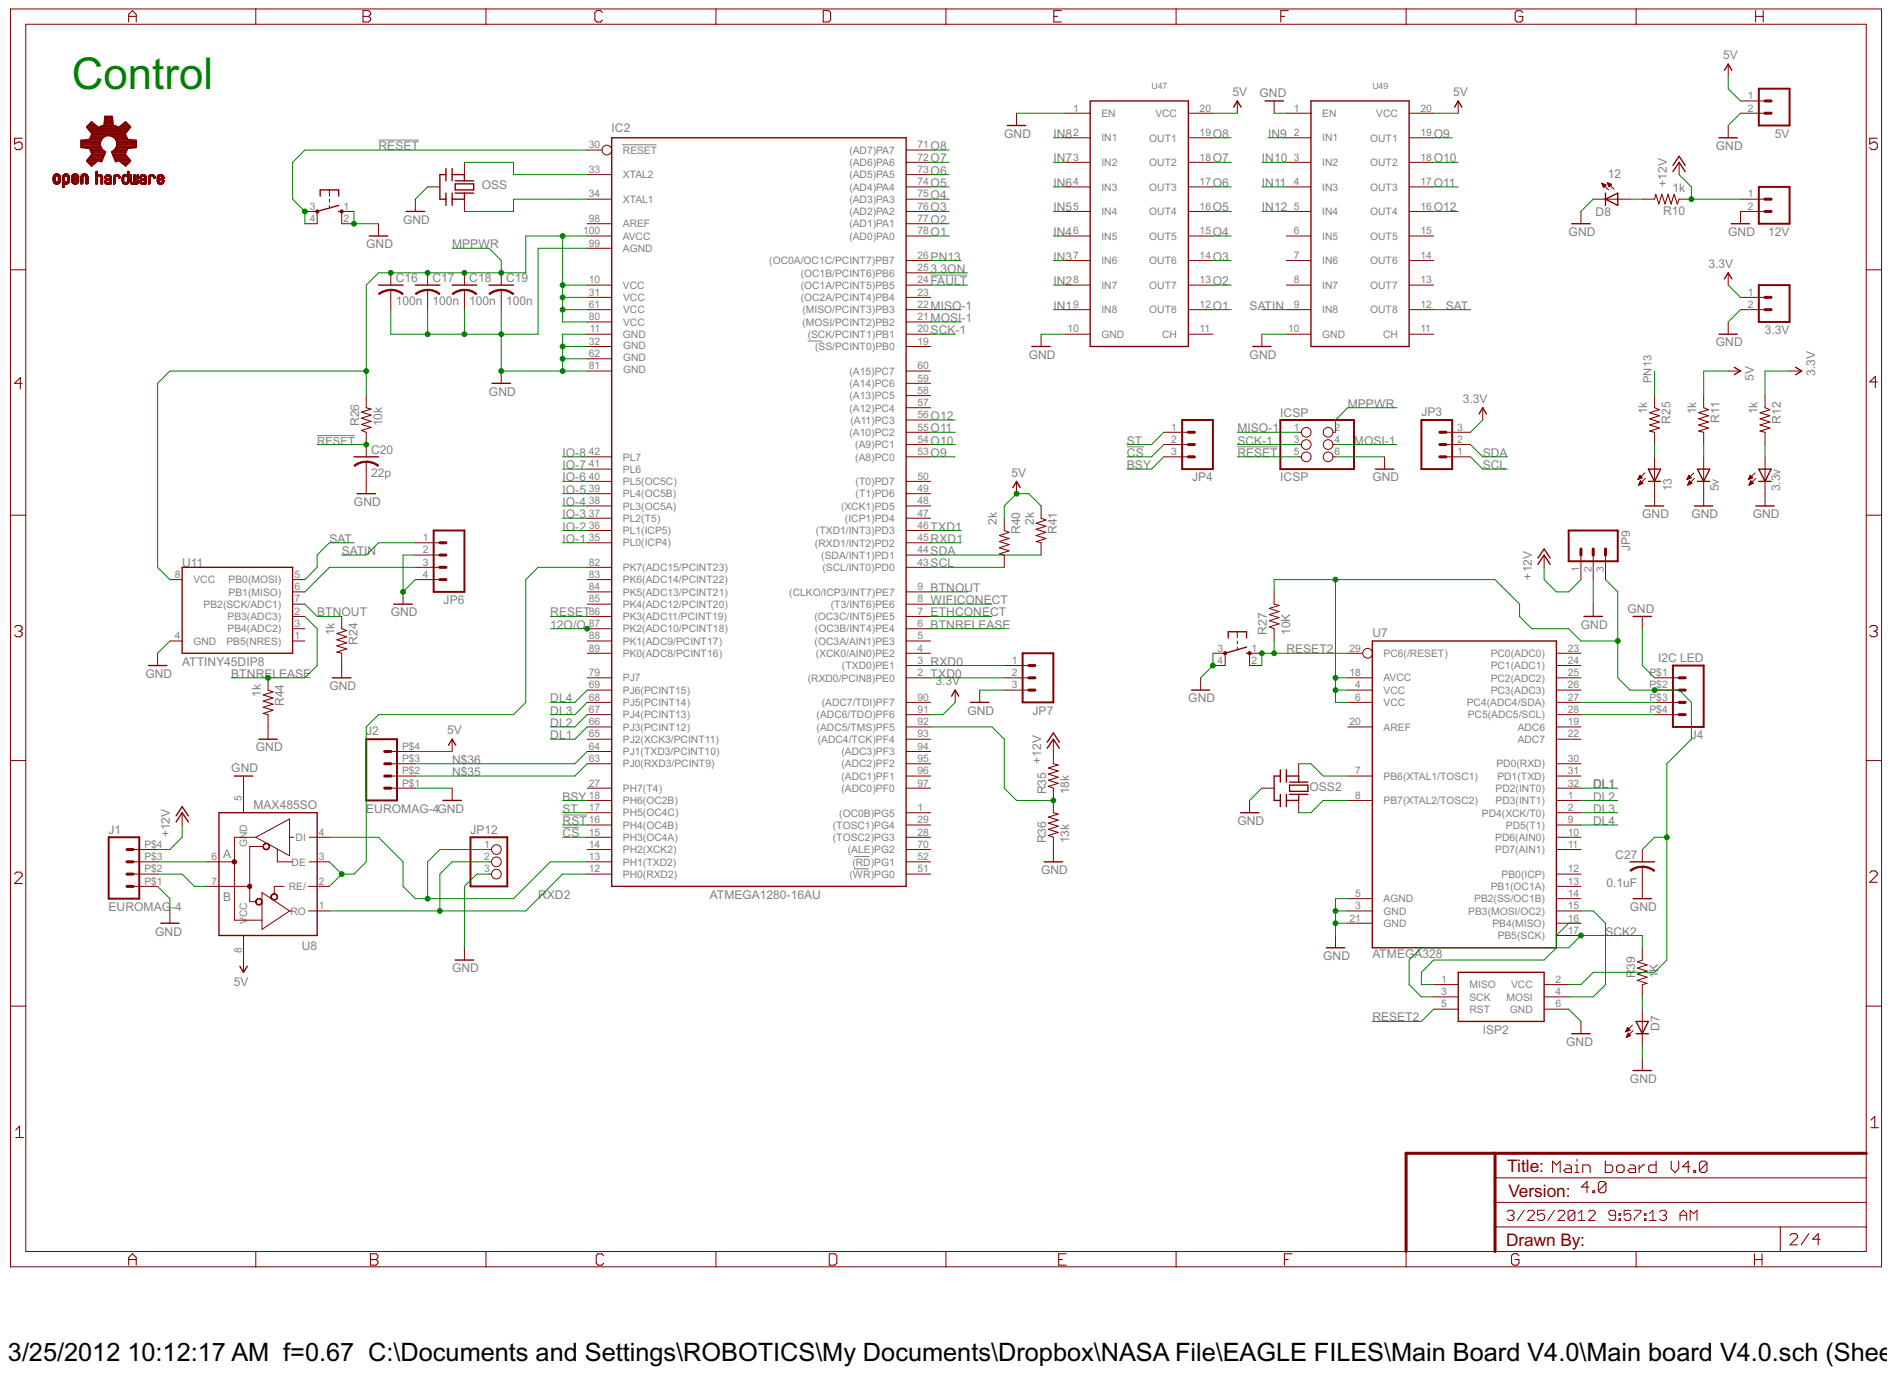
[picture p21: page 2]

Drawn By: Title: Version:

3/25/2012 10:12:17 AM f=0.67 C:\Documents and Settings\ROBOTICS\My Documents\Dropbox\NASA File\EAGLE FILES\Main Board V4.0\Main board V4.0.sch (Sheet: 2/4)

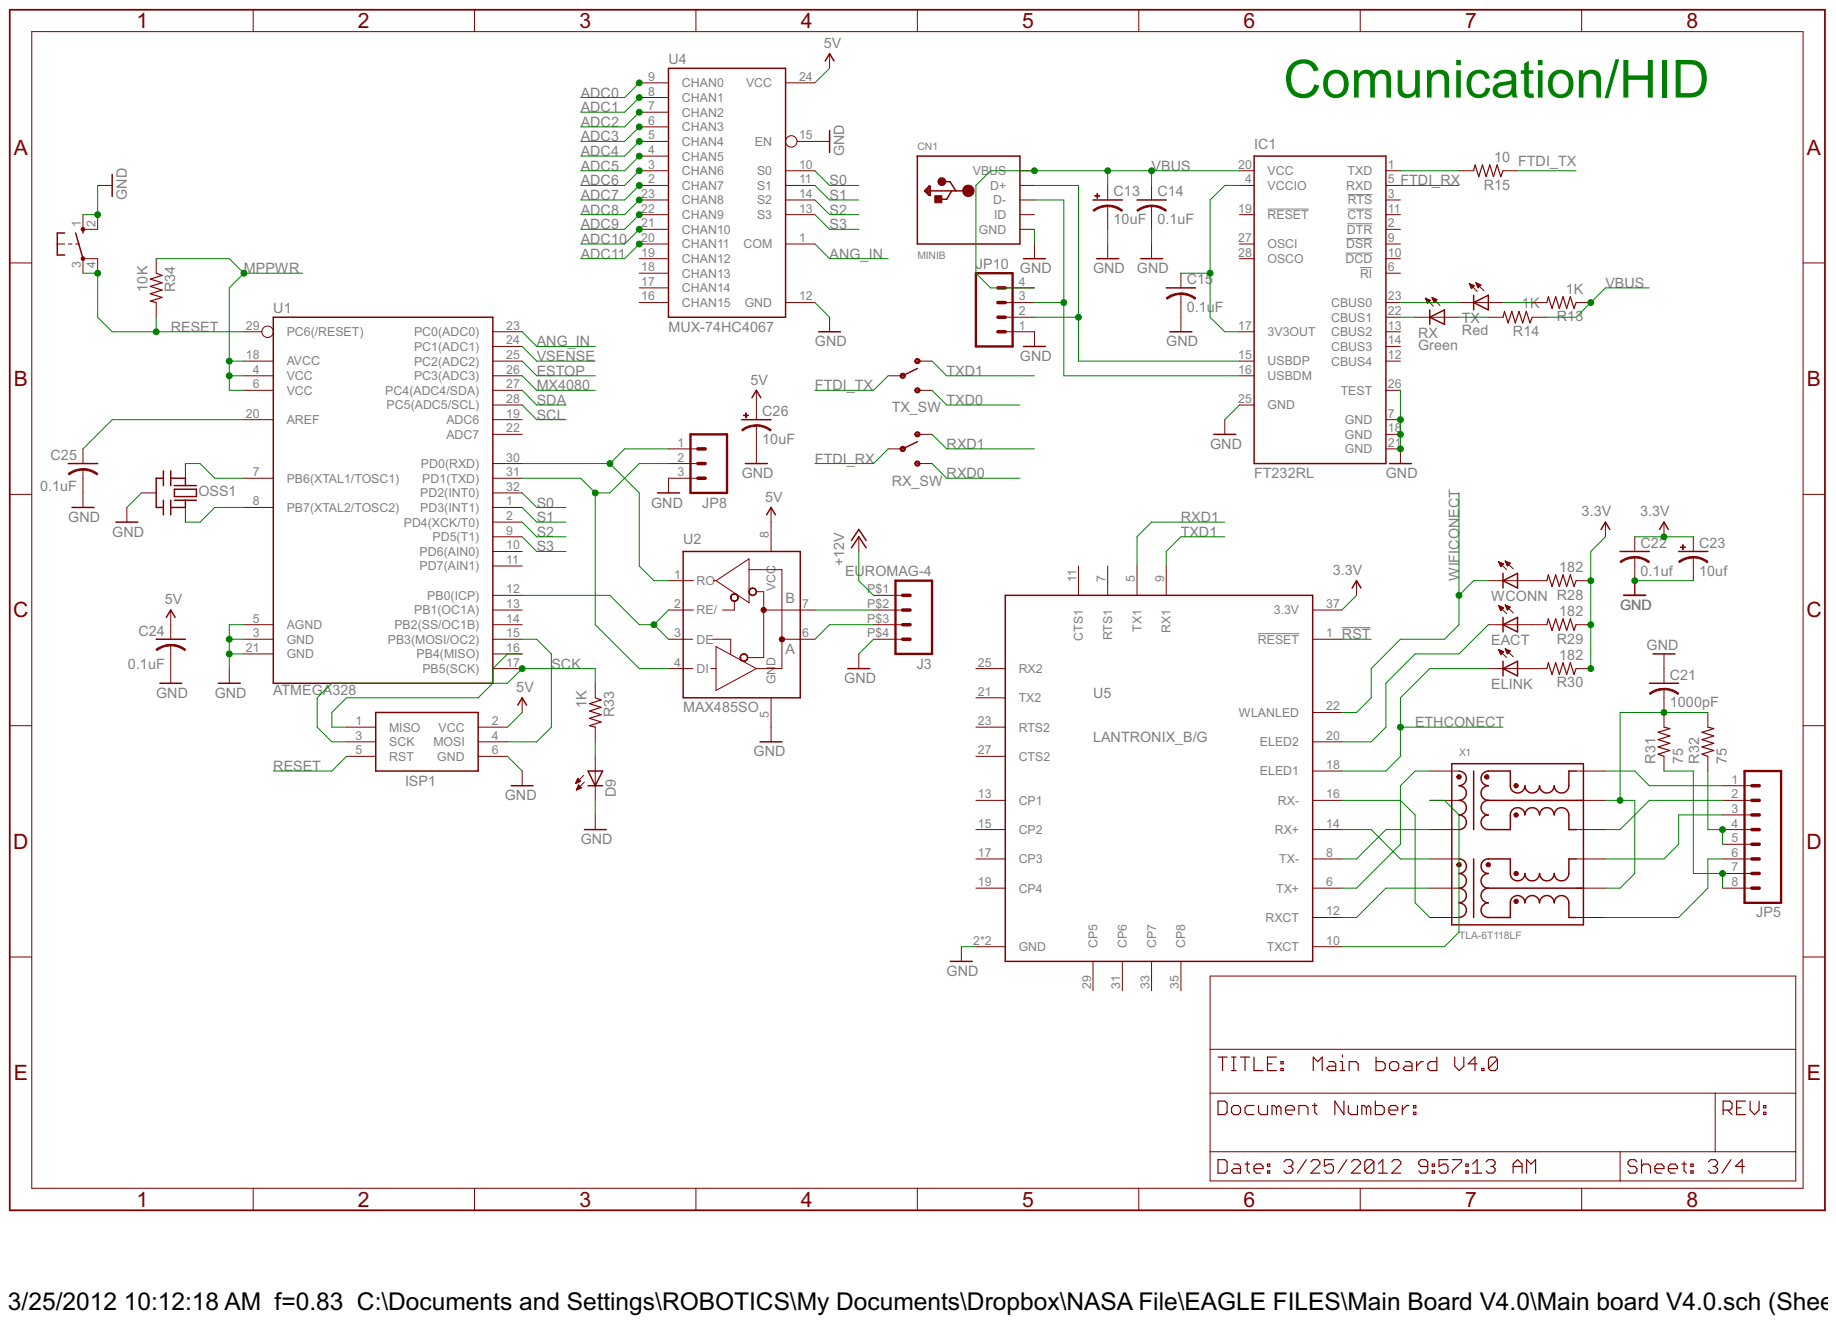
[picture p22: page 3]

GND GND

3/25/2012 10:12:18 AM f=0.83 C:\Documents and Settings\ROBOTICS\My Documents\Dropbox\NASA File\EAGLE FILES\Main Board V4.0\Main board V4.0.sch (Sheet: 3/4)

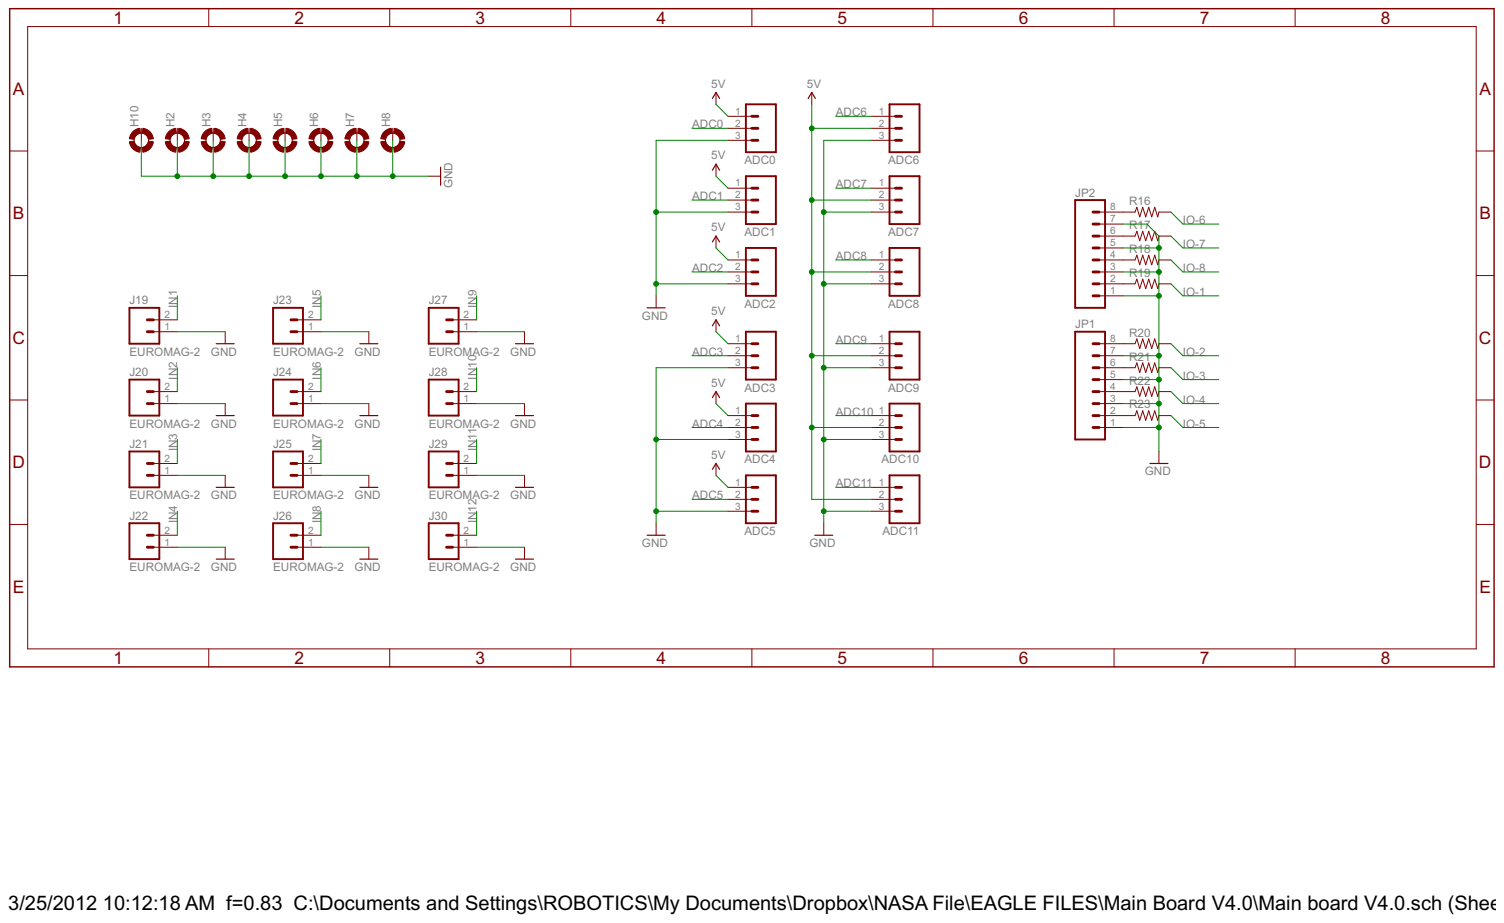
[picture p23: page 4]

GND GND

3/25/2012 10:12:18 AM f=0.83 C:\Documents and Settings\ROBOTICS\My Documents\Dropbox\NASA File\EAGLE FILES\Main Board V4.0\Main board V4.0.sch (Sheet: 4/4)
