UA-Robotics/UA-NASA-Robotic-Mining-2012-Hardware/Ext. Sens Board/Ext. Sense board.pdf

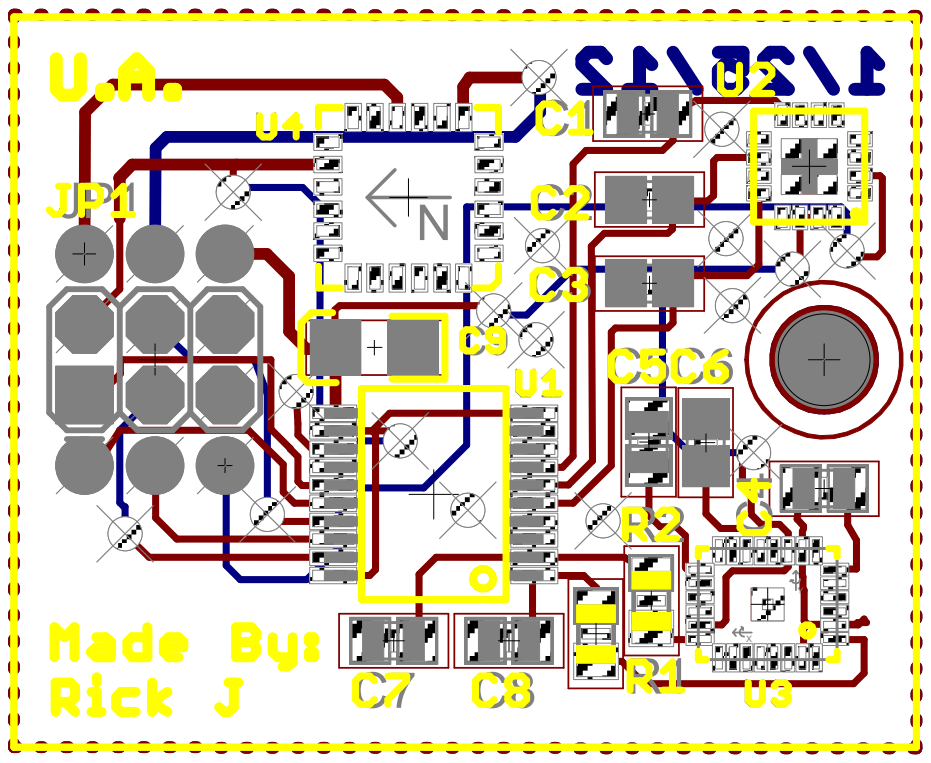
[picture p24: page 1]
