UA-Robotics/UA-NASA-Robotic-Mining-2012-Hardware/Ext. Sens Board/Ext. Sense Sch.pdf

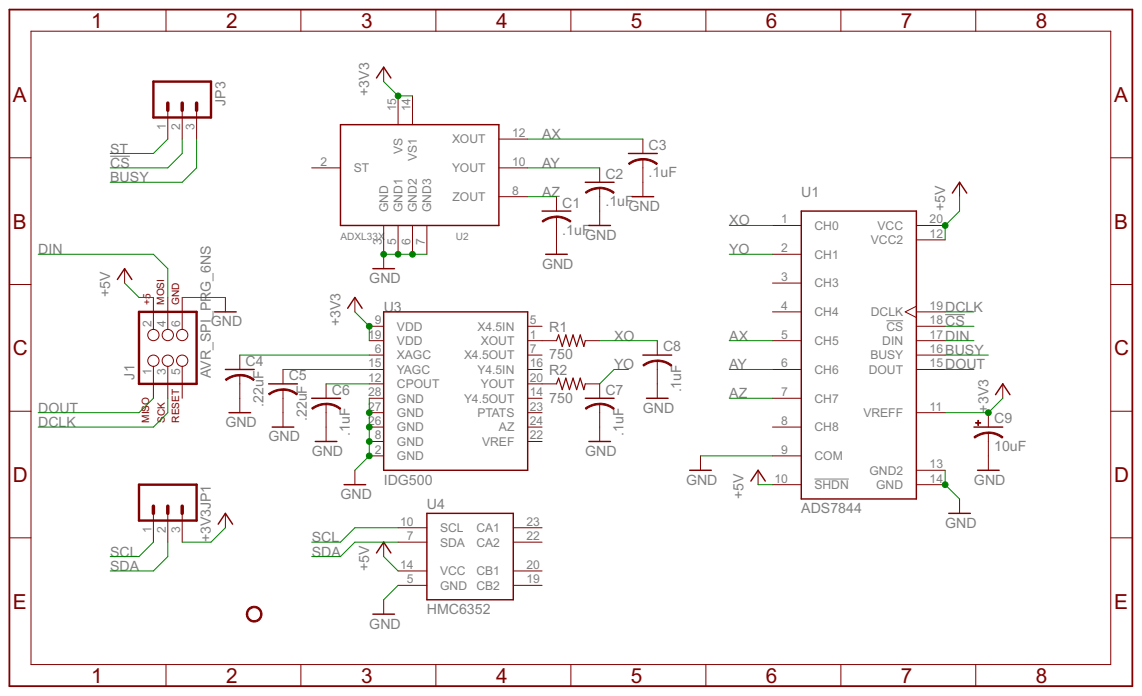
[picture p25: page 1]
