UA-Robotics/UA-NASA-Robotic-Mining-2012-Hardware/Motor Control/Motor Control_BRD.pdf

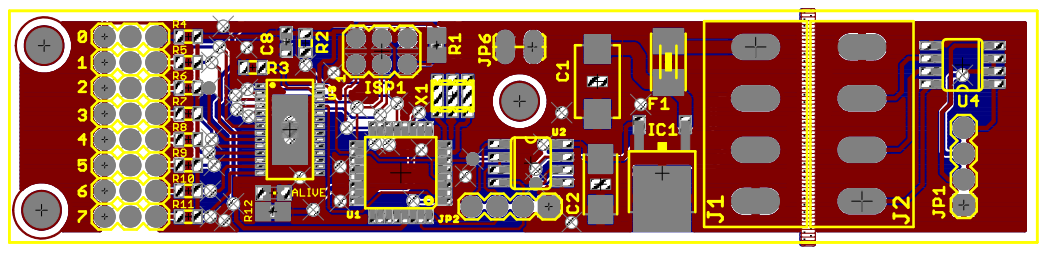
[picture p26: page 1]
