UA-Robotics/UA-NASA-Robotic-Mining-2012-Hardware/Motor Control/Motor Control_SCH.pdf

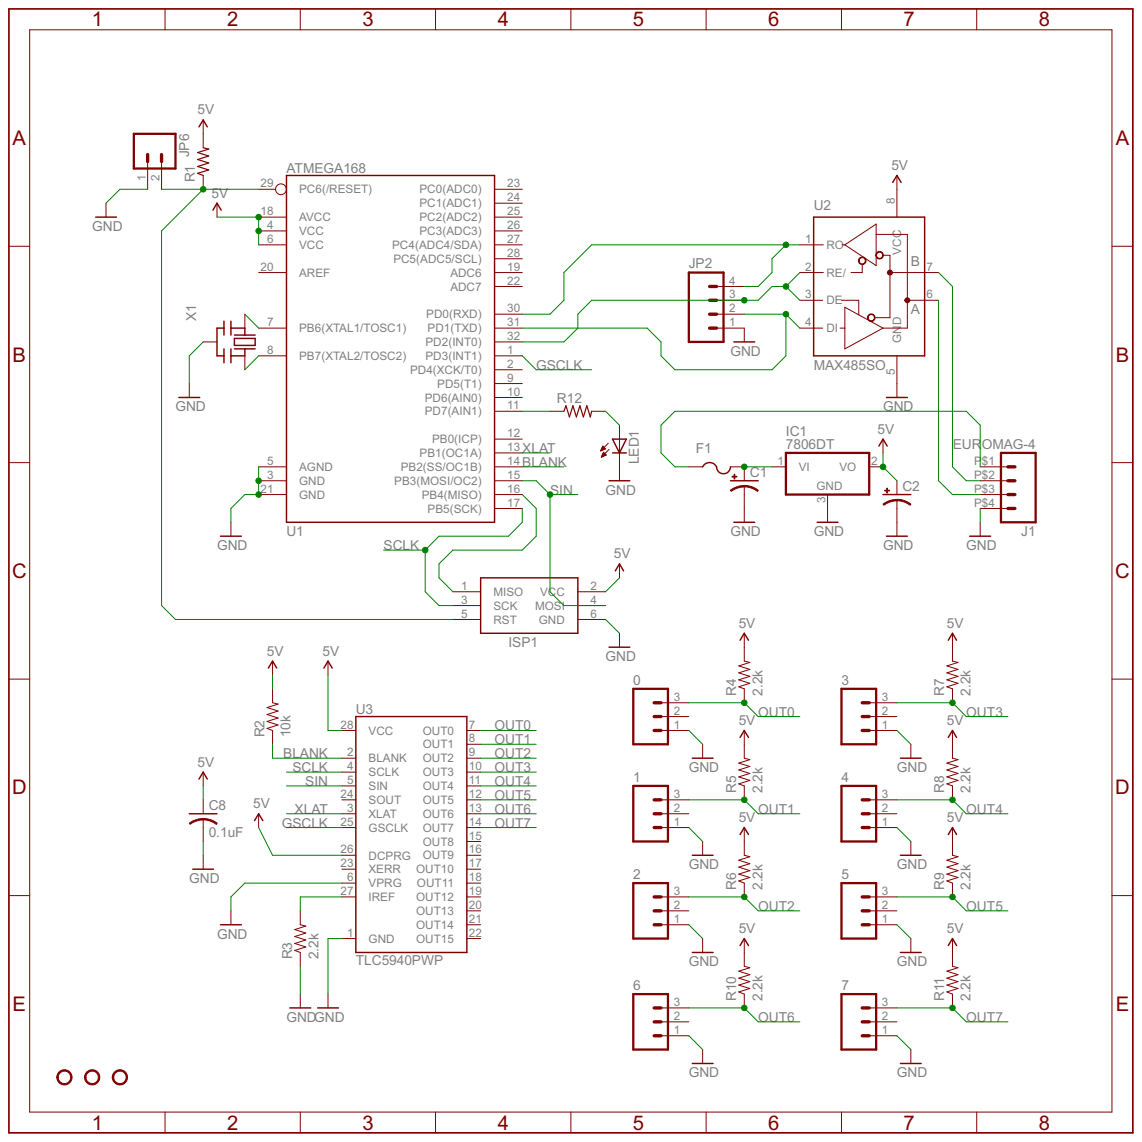
[picture p27: page 1]
