UA-Robotics/UA-NASA-Robotic-Mining-2012-Hardware/Ext. Sens Board/Ext. Sense board.brd

## EAGLE design Ext. Sens Board/Ext. Sense board.brd (2015-08-14)

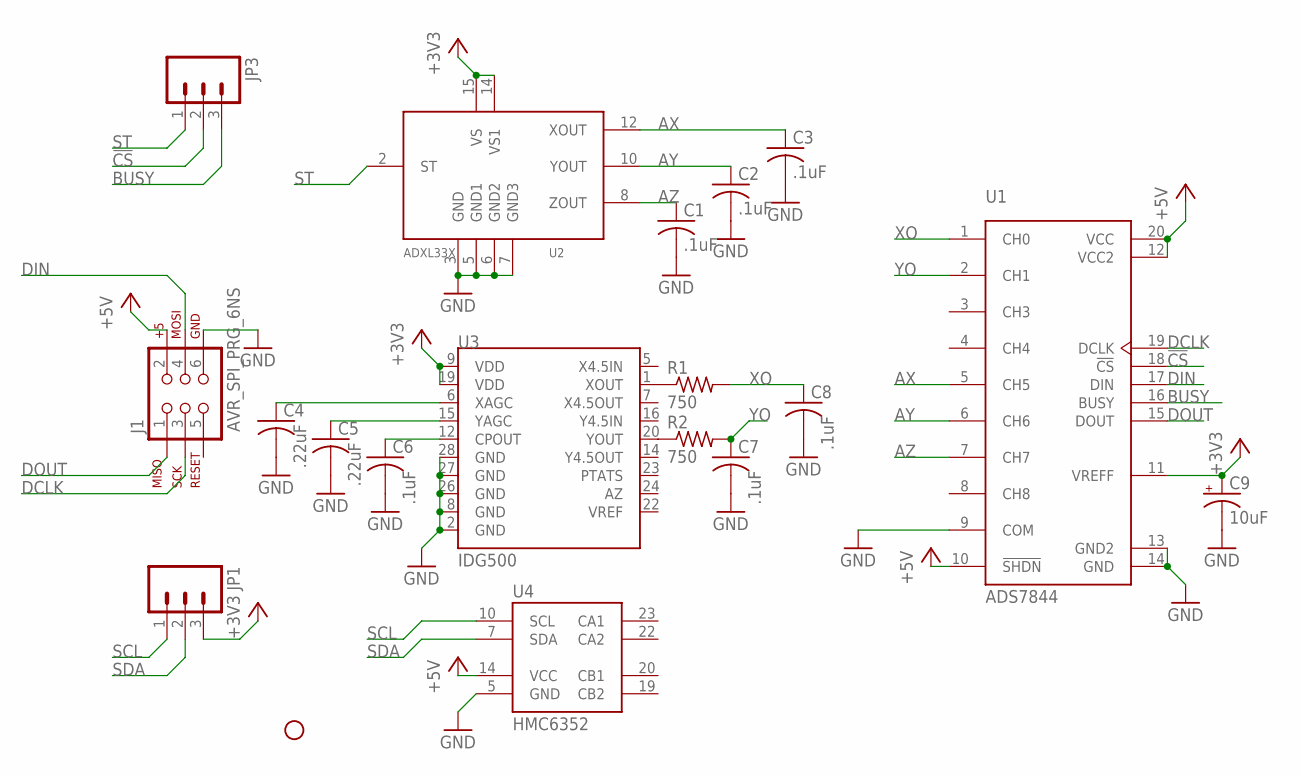
[picture p28: schematic Ext. Sense board.sch]

Parts:
C1, C2, C3, C6, C7, C8: .1uF; C0805
C4, C5: .22uF; C0805
C9: 10uF; POLC1206
J1: AVR_SPI_PRG_6NS; 2X3-NS
JP1, JP3: M031X03_NO_SILK; 1X03_NO_SILK
JP2: STAND-OFF
R1, R2: 750; R0805
U1: ADS7844; SSOP-20
U2: ADXL33X; 16LCSP
U3: IDG500; SPARKFUN_IDG500
U4: HMC6352; LCC24

Connections:
!CS: JP3.2, U1.18 (!CS)
+3V3: C9.1 (+), JP1.3, U1.11 (VREFF), U2.14 (VS1), U2.15 (VS), U3.9 (VDD), U3.19 (VDD)
+5V: J1.2, U1.10 (!SHDN), U1.12 (VCC2), U1.20 (VCC), U4.14 (VCC)
AX: C3.1, U1.5 (CH5), U2.12 (XOUT)
AY: C2.1, U1.6 (CH6), U2.10 (YOUT)
AZ: C1.1, U1.7 (CH7), U2.8 (ZOUT)
BUSY: JP3.3, U1.16 (BUSY)
DCLK: J1.3, U1.19 (DCLK)
DIN: J1.4, U1.17 (DIN)
DOUT: J1.1, U1.15 (DOUT)
GND: C1.2, C2.2, C3.2, C4.2, C5.2, C6.2, C7.2, C8.2, C9.2 (-), J1.6, U1.9 (COM), U1.13 (GND2), U1.14 (GND), U2.3 (GND), U2.5 (GND1), U2.6 (GND2), U2.7 (GND3), U3.2 (GND), U3.8 (GND), U3.26 (GND), U3.27 (GND), U3.28 (GND), U4.5 (GND)
unnamed: C4.1, U3.6 (XAGC)
unnamed: C5.1, U3.15 (YAGC)
unnamed: C6.1, U3.12 (CPOUT)
unnamed: R1.1, U3.1 (XOUT)
unnamed: R2.1, U3.20 (YOUT)
SCL: JP1.1, U4.10 (SCL)
SDA: JP1.2, U4.7 (SDA)
ST: JP3.1, U2.2 (ST)
XO: C8.1, R1.2, U1.1 (CH0)
YO: C7.1, R2.2, U1.2 (CH1)

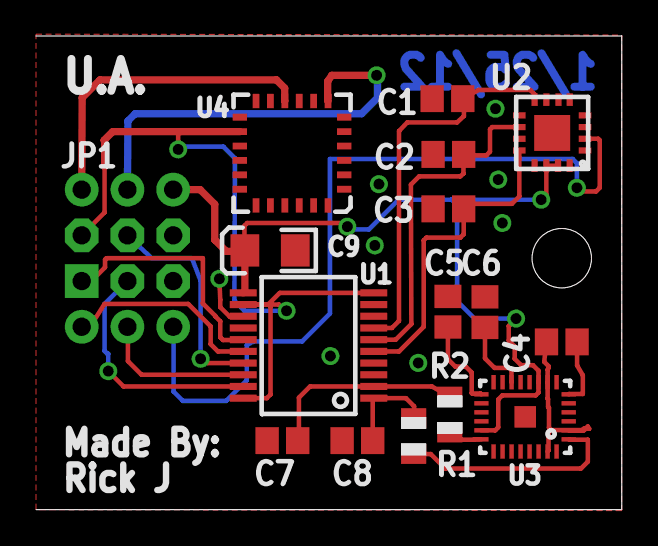
[picture p29: board Ext. Sense board.brd from above]

Board: 2 copper layers, 32.5 x 26.3 mm, 19 parts (0 on the bottom side), 21 nets.
