UA-Robotics/UA-NASA-Robotic-Mining-2012-Hardware/Motor Control/Motor Control.brd

## EAGLE design Motor Control/Motor Control.brd (2015-08-14)

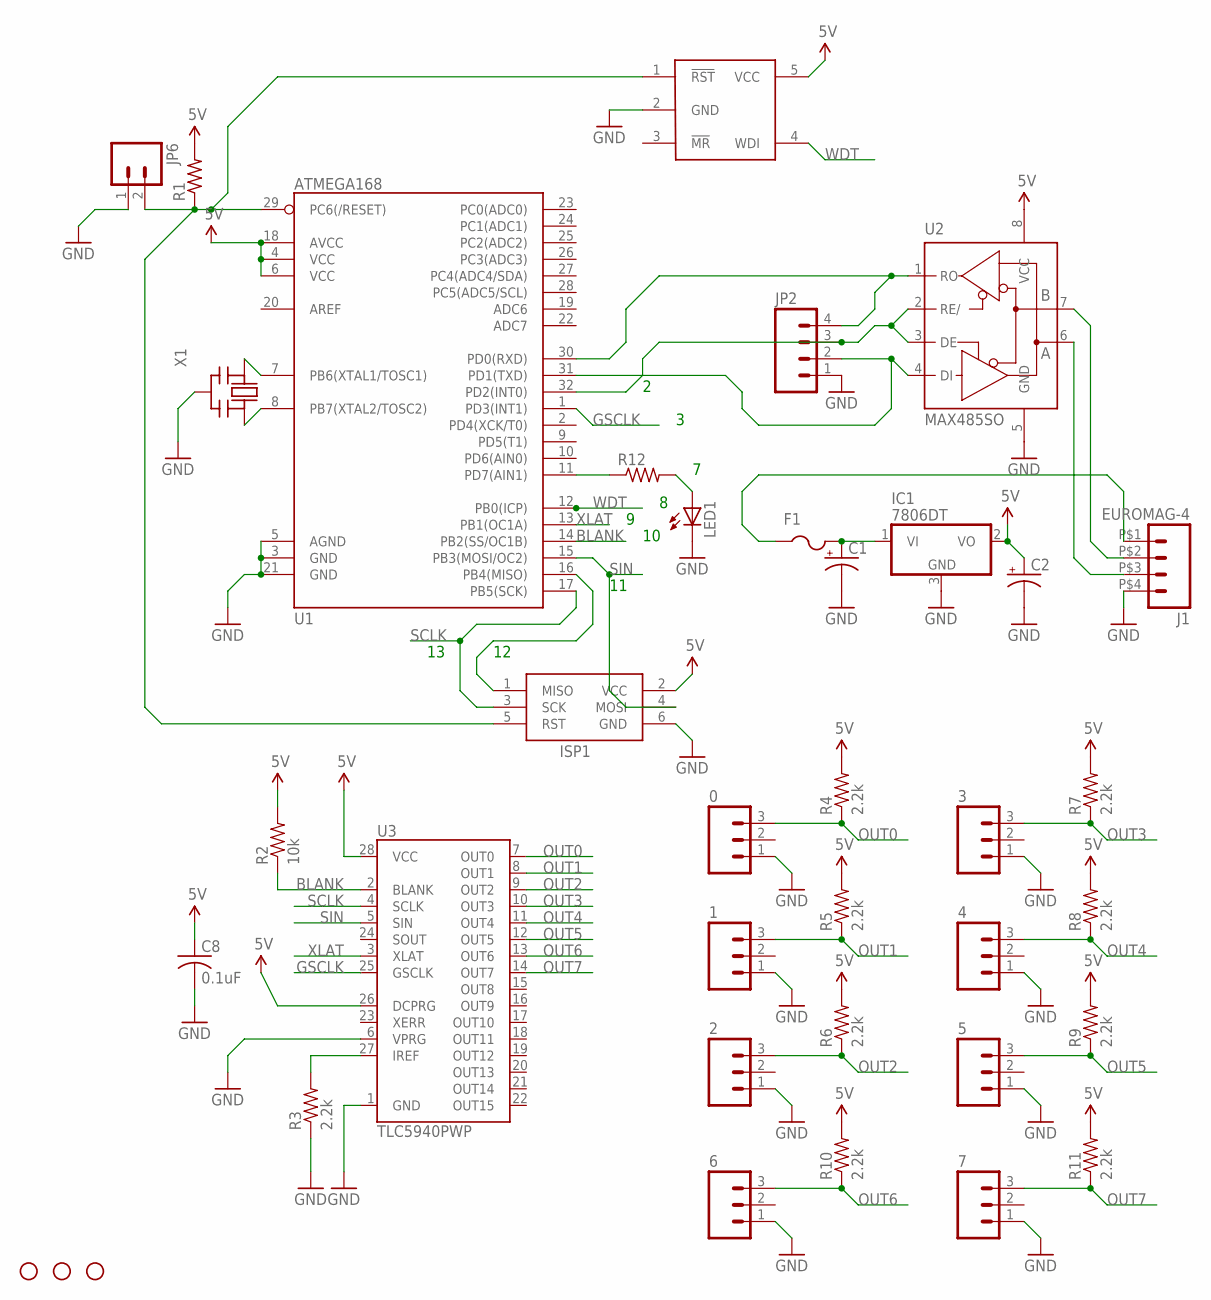
[picture p30: schematic Motor Control.sch, sheet 1]

Parts:
0, 1, 2, 3, 4, 5, 6, 7: M03PTH; 1X03
C1: CPOL-USCT7343; CT7343
C2: CPOL-USCT6032; CT6032
C8: 0.1uF; C0603
F1: PTCFUSE-1812; 1812
IC1: 7806DT; TO252
ISP1: AVRISP-6; AVRISP
J1: EUROMAG-4; M4
JP2: M04PTH; 1X04
JP3, JP4, JP5: STAND-OFF
JP6: M02LOCK_LONGPADS; 1X02_LOCK_LONGPADS
LED1: LEDCHIPLED_0805; CHIPLED_0805
R1, R12: R-US_M0805; M0805
R2: 10k; 0805
R3, R4, R5, R6, R7, R8, R9, R10, R11: 2.2k; 0805
U1: ATMEGA168; TQFP32-08
U2: MAX485SO; SO08
U3: TLC5940PWP; TSSOP28-GROUNDPAD
U$18: MAX823; SOT23-5L
X1: CERMOSCILL-AWCSR; AWCSR

Connections:
5V: C2.+, C8.1, IC1.2 (VO), ISP1.2 (VCC), R1.2, R2.2, R4.2, R5.2, R6.2, R7.2, R8.2, R9.2, R10.2, R11.2, U1.4 (VCC), U1.6 (VCC), U1.18 (AVCC), U2.8 (VCC), U3.26 (DCPRG), U3.28 (VCC), U$18.5 (VCC)
BLANK: R2.1, U1.14 (PB2(SS/OC1B)), U3.2 (BLANK)
GND: 0.1, 1.1, 2.1, 3.1, 4.1, 5.1, 6.1, 7.1, C1.-, C2.-, C8.2, IC1.3 (GND), ISP1.6 (GND), J1.P$4 (4), JP2.1, JP6.1, LED1.C, R3.1, U1.3 (GND), U1.5 (AGND), U1.21 (GND), U2.5 (GND), U3.1 (GND), U3.6 (VPRG), U$18.2 (GND), X1.2 (GND); also elsewhere on the board
GSCLK: U1.1 (PD3(INT1)), U3.25 (GSCLK)
unnamed: JP2.3, U1.32 (PD2(INT0)), U2.2 (RE/), U2.3 (DE)
unnamed: JP2.4, U1.30 (PD0(RXD)), U2.1 (RO)
unnamed: JP2.2, U1.31 (PD1(TXD)), U2.4 (DI)
unnamed: ISP1.5 (RST), JP6.2, R1.1, U1.29 (PC6(/RESET)), U$18.1 (!RST)
unnamed: U1.8 (PB7(XTAL2/TOSC2)), X1.3 (OUT)
unnamed: F1.1, J1.P$1 (1)
unnamed: ISP1.1 (MISO), U1.16 (PB4(MISO))
unnamed: C1.+, F1.2, IC1.1 (VI)
unnamed: U1.7 (PB6(XTAL1/TOSC1)), X1.1 (IN)
unnamed: R3.2, U3.27 (IREF)
unnamed: J1.P$2 (2), U2.7 (B)
unnamed: J1.P$3 (3), U2.6 (A)
unnamed: R12.1, U1.11 (PD7(AIN1))
unnamed: LED1.A, R12.2
OUT0: 0.3, R4.1, U3.7 (OUT0)
OUT1: 1.3, R5.1, U3.8 (OUT1)
OUT2: 2.3, R6.1, U3.9 (OUT2)
OUT3: 3.3, R7.1, U3.10 (OUT3)
OUT4: 4.3, R8.1, U3.11 (OUT4)
OUT5: 5.3, R9.1, U3.12 (OUT5)
OUT6: 6.3, R10.1, U3.13 (OUT6)
OUT7: 7.3, R11.1, U3.14 (OUT7)
SCLK: ISP1.3 (SCK), U1.17 (PB5(SCK)), U3.4 (SCLK)
SIN: ISP1.4 (MOSI), U1.15 (PB3(MOSI/OC2)), U3.5 (SIN)
WDT: U1.12 (PB0(ICP)), U$18.4 (WDI)
XLAT: U1.13 (PB1(OC1A)), U3.3 (XLAT)

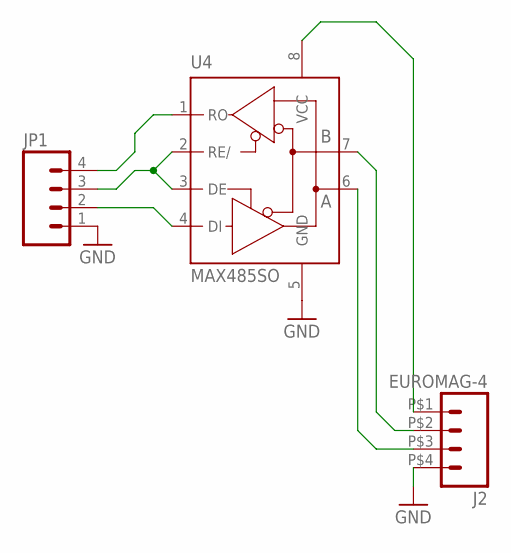
[picture p31: schematic Motor Control.sch, sheet 2]

Parts:
J2: EUROMAG-4; M4
JP1: M04PTH; 1X04
U4: MAX485SO; SO08

Connections:
GND: J2.P$4 (4), JP1.1, U4.5 (GND); also elsewhere on the board
unnamed: JP1.3, U4.2 (RE/), U4.3 (DE)
unnamed: JP1.4, U4.1 (RO)
unnamed: JP1.2, U4.4 (DI)
unnamed: J2.P$1 (1), U4.8 (VCC)
unnamed: J2.P$2 (2), U4.7 (B)
unnamed: J2.P$3 (3), U4.6 (A)

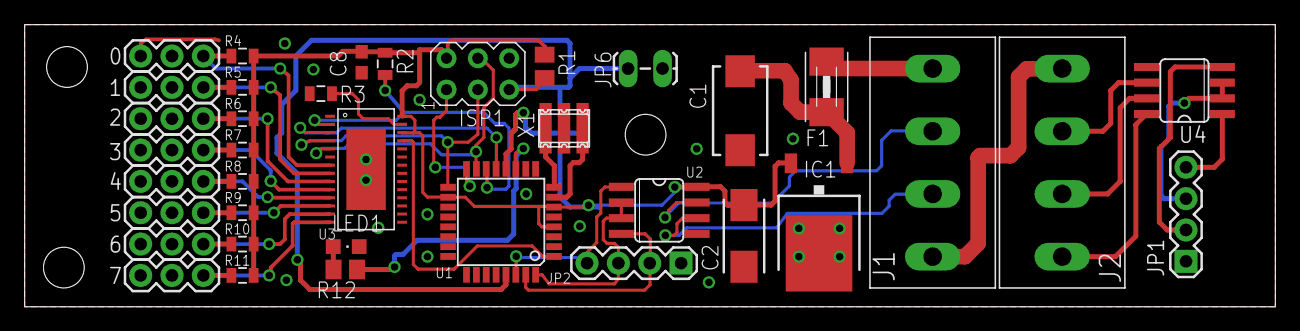
[picture p32: board Motor Control.brd from above]

Board: 2 copper layers, 101.3 x 22.9 mm, 41 parts (1 on the bottom side), 36 nets.
