UA-Robotics/UA-NASA-Robotic-Mining-2012-Hardware/Main Board V4.0/Main board V4.0.brd

## EAGLE design Main Board V4.0/Main board V4.0.brd (2015-08-14)

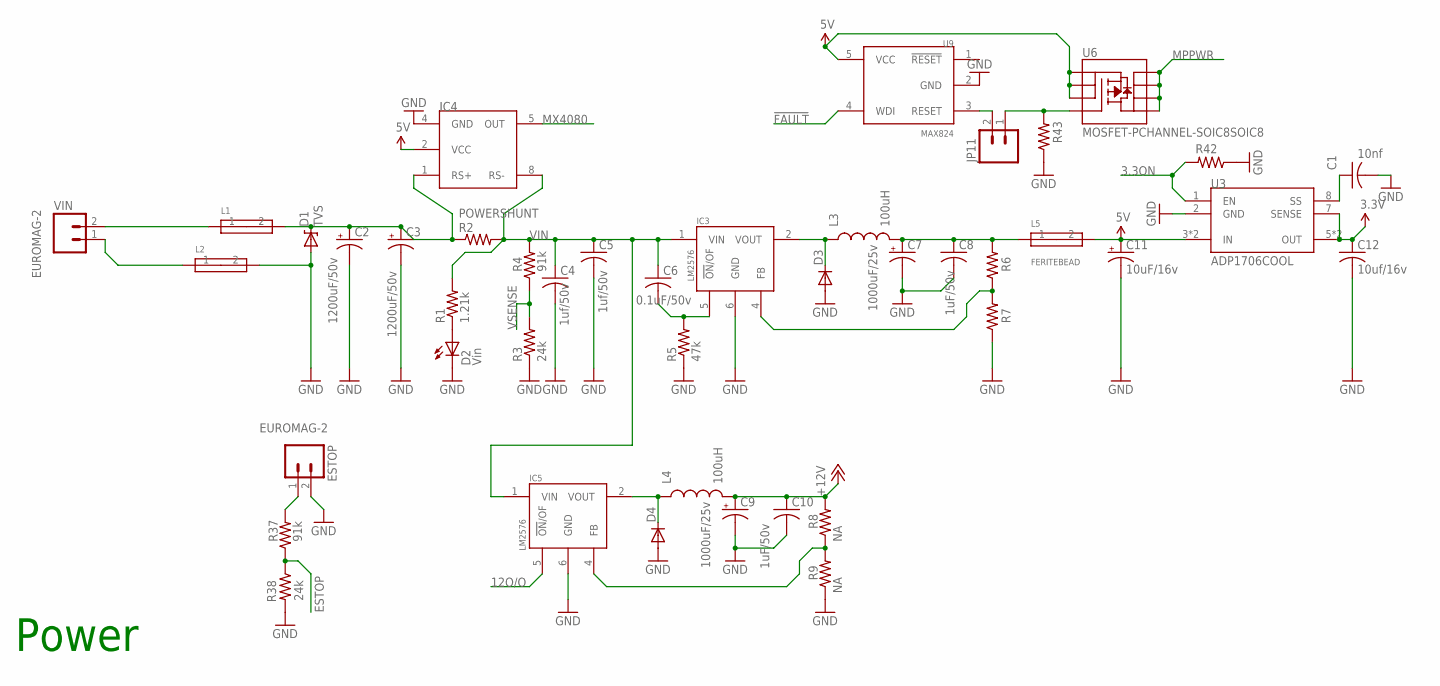
[picture p33: schematic Main board V4.0.sch, sheet 1]

Parts:
C1: 10nf; C0805
C2, C3: 1200uF/50v; CAN_18MM
C4, C5: 1uf/50v; C0805
C6: 0.1uF/50v; C0805
C7, C9: 1000uF/25v; CAN_18MM
C8, C10: 1uF/50v; C0805
C11: 10uF/16v; E3,5-10
C12: 10uf/16v; C0805
D1: TVS; DO-214AC
D2: Vin; CHIP-LED0805
D3, D4: DIODE-SMC; SMC
ESTOP: EUROMAG-2; M2
IC3, IC5: LM2576; TO-263-5
IC4: MAX4080; SO08
JP11: M02LOCK_LONGPADS; 1X02_LOCK_LONGPADS
L1, L2, L5: FERITEBEAD; 0603
L3, L4: 100uH; INDUCTOR_5X3
R1: 1.21k; R0805
R2: POWERSHUNT; RW3R5EAR100JE
R3, R38: 24k; R0805
R4, R37: 91k; R0805
R5: 47k; R0805
R6, R7, R8, R9, R42, R43: NA; R0805
U3: ADP1706COOL; SO-8COOL
U6: MOSFET-PCHANNEL-SOIC8SOIC8; SO08
U9: MAX824; SOT-5L
VIN: EUROMAG-2; M2

Connections:
3.3ON: R42.2, U3.1 (EN); also elsewhere on the board
3.3V: C12.1, U3.5 (OUT), U3.6 (OUT), U3.7 (SENSE); also elsewhere on the board
5V: C11.+, IC4.2 (VCC), L5.2, U3.3 (IN), U3.4 (IN), U6.1 (S), U6.2 (S), U6.3 (S), U9.5 (VCC); also elsewhere on the board
12O/O: IC5.5 (!ON!/OF); also elsewhere on the board
!FAULT: U9.4 (WDI); also elsewhere on the board
+12V: C9.+, C10.1, L4.2, R8.2; also elsewhere on the board
ESTOP: R37.1, R38.1; also elsewhere on the board
GND: C1.2, C2.-, C3.-, C4.2, C5.2, C7.-, C8.2, C9.-, C10.2, C11.-, C12.2, D1.A, D2.C, D3.A, D4.A, ESTOP.2, IC3.6 (GND), IC4.4 (GND), IC5.6 (GND), L2.2, R3.1, R5.1, R7.1, R9.1, R38.2, R42.1, R43.1, U3.2 (GND), U9.2 (GND); also elsewhere on the board
MPPWR: U6.5 (D), U6.6 (D), U6.7 (D), U6.8 (D); also elsewhere on the board
MX4080: IC4.5 (OUT); also elsewhere on the board
unnamed: C6.2, IC3.5 (!ON!/OF), R5.2
unnamed: D4.C, IC5.2 (VOUT), L4.1
unnamed: D3.C, IC3.2 (VOUT), L3.1
unnamed: JP11.1, R43.2, U6.4 (G)
unnamed: JP11.2, U9.3 (RESET)
unnamed: L1.1, VIN.2
unnamed: ESTOP.1, R37.2
unnamed: C2.+, C3.+, D1.C, IC4.1 (RS+), L1.2, R2.1
unnamed: IC3.4 (FB), R6.1, R7.2
unnamed: IC5.4 (FB), R8.1, R9.2
unnamed: D2.A, R1.1
unnamed: L2.1, VIN.1
unnamed: C7.+, C8.1, L3.2, L5.1, R6.2
unnamed: C1.1, U3.8 (SS)
VIN: C4.1, C5.1, C6.1, IC3.1 (VIN), IC4.8 (RS-), IC5.1 (VIN), R1.2, R2.2, R4.2
VSENSE: R3.2, R4.1; also elsewhere on the board

Notes on the sheet:
Power
IC4

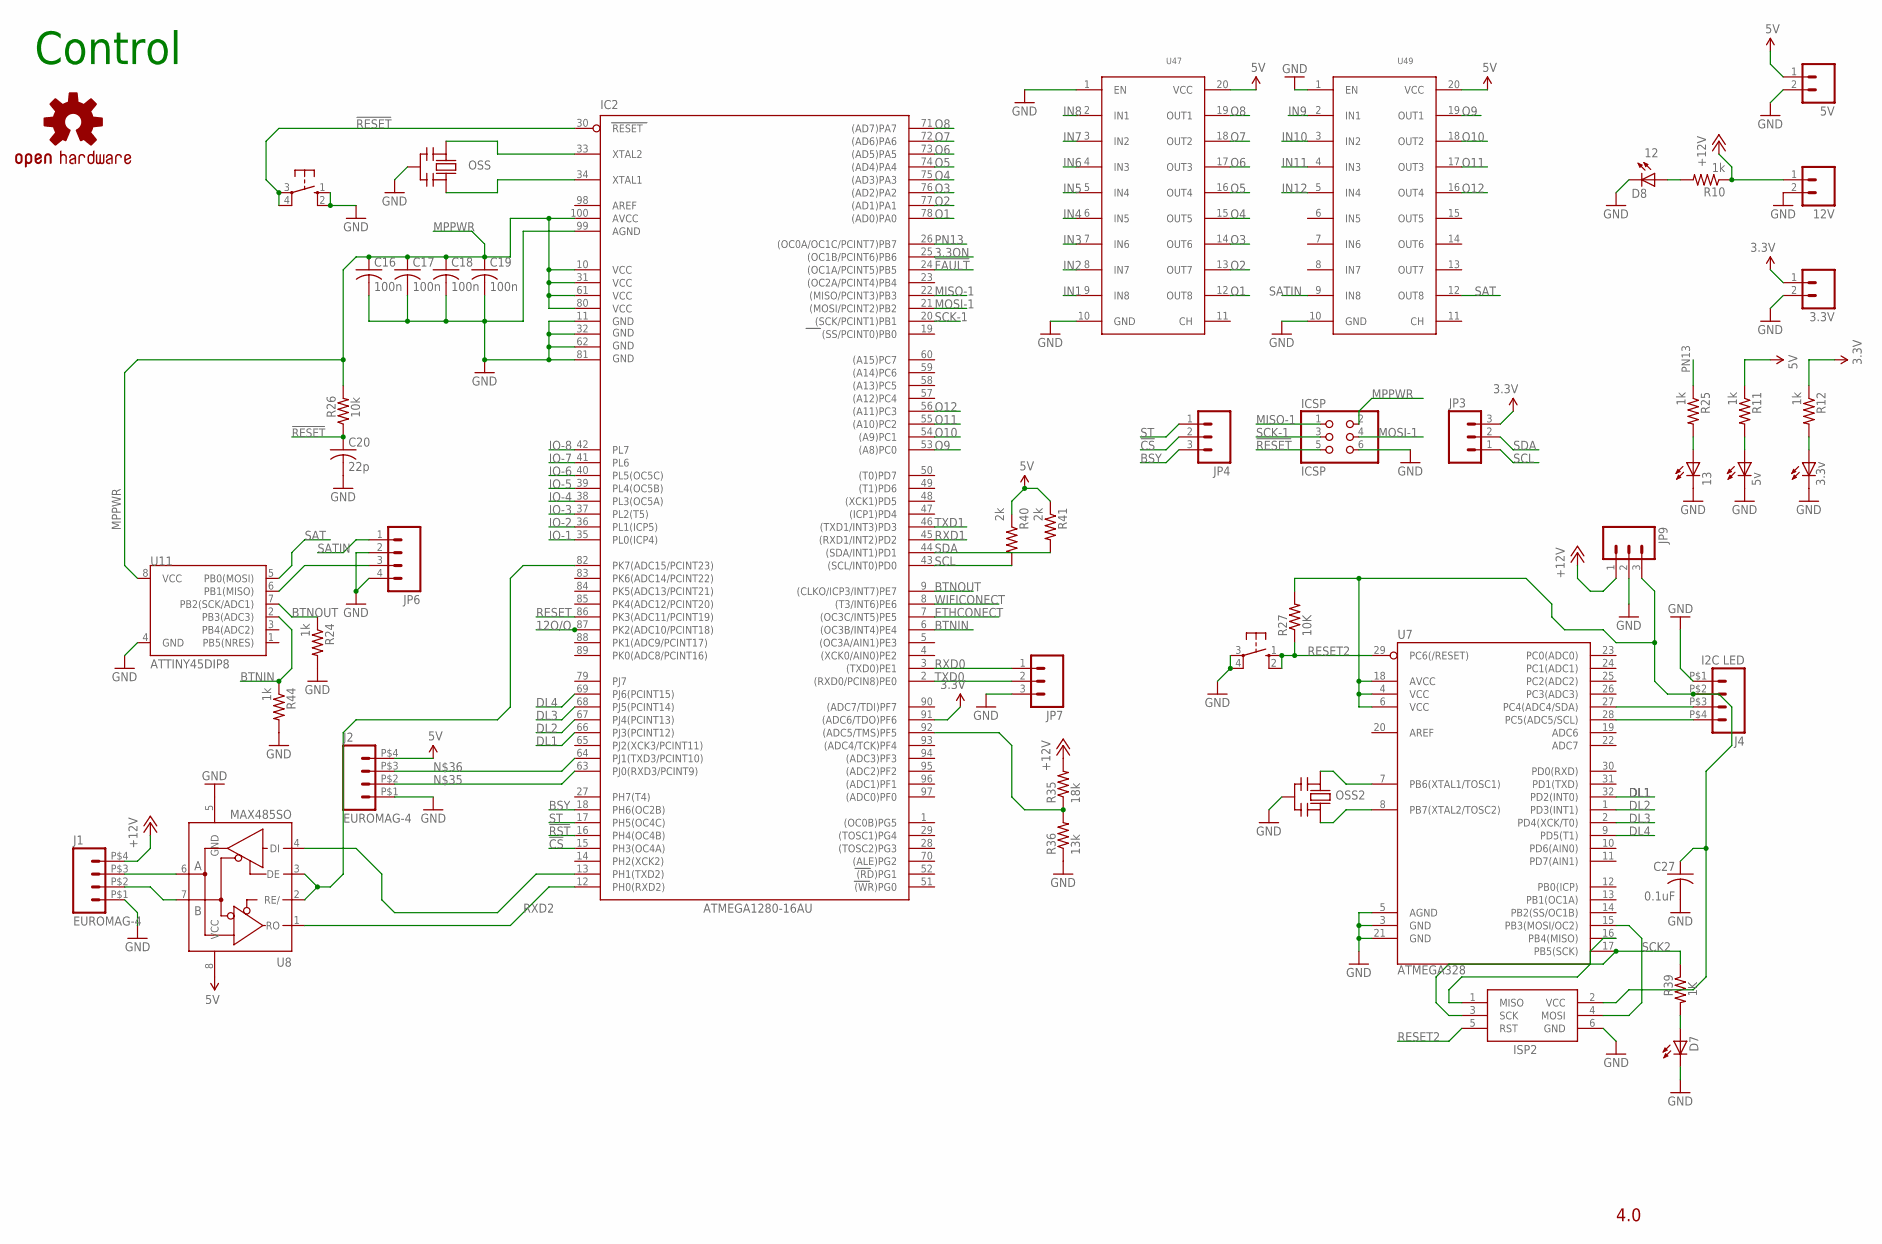
[picture p34: schematic Main board V4.0.sch, sheet 2]

Parts:
3.3V, 5V, 12V: EUROMAG-2; M2
13: LEDCHIP-LED0805; CHIP-LED0805
C16, C17, C18, C19: 100n; C0805
C20: 22p; C0805
C27: 0.1uF; C0805
D5: 5v; CHIP-LED0805
D6: 3.3v; CHIP-LED0805
D7: LEDCHIP-LED0805; CHIP-LED0805
D8: 12; CHIP-LED0805
IC2: ATMEGA1280-16AU; TQFP100
ICSP: ICSP; 2X03
ISP2: AVRISP-6; AVRISP
J1, J2: EUROMAG-4; M4
J4: I2C LED; M4
JP3, JP4: M03PTH; 1X03
JP6: M04LOCK_LONGPADS; 1X04_LOCK_LONGPADS
JP7: M03LOCK; 1X03_LOCK
JP9: M03LOCK_LONGPADS; 1X03_LOCK_LONGPADS
OSS, OSS2: CERMOSCILL-AWCSR; AWCSR
R10, R11, R12, R24, R25, R44: 1k; R0805
R26: 10k; R0805
R27: 10K; 0805
R35: 18k; R0805
R36: 13k; R0805
R39: 1K; 0805
R40, R41: 2k; R0805
S1, S4: 10-XX; B3F-10XX
U7: ATMEGA328; TQFP32-08
U8: MAX485SO; SO08
U11: ATTINY45DIP8; DIP08
U47, U49: MAX6818; SSOP-20
U$3: OSHW-LOGOL; OSHW-LOGO-L

Connections:
3.3ON: IC2.25 ((OC1B/PCINT6)PB6); also elsewhere on the board
3.3V: 3.3V.1, IC2.91 ((ADC6/TDO)PF6), JP3.3, R12.1; also elsewhere on the board
5V: 5V.1, J2.P$4 (4), R11.1, R40.1, R41.1, U8.8 (VCC), U47.20 (VCC), U49.20 (VCC); also elsewhere on the board
12O/O: IC2.87 (PK2(ADC10/PCINT18)); also elsewhere on the board
!CS: IC2.15 (PH3(OC4A)), JP4.2
!FAULT: IC2.24 ((OC1A/PCINT5)PB5); also elsewhere on the board
!RESET: C20.1, IC2.30 (RESET), ICSP.5, R26.1, S1.3, S1.4 (P1)
!RST: IC2.16 (PH4(OC4B)); also elsewhere on the board
+12V: 12V.1, J1.P$4 (4), JP9.1, R10.1, R35.2; also elsewhere on the board
BSY: IC2.18 (PH6(OC2B)), JP4.3
BTNIN: IC2.6 ((OC3B/INT4)PE4), R44.1, U11.2 (PB3(ADC3))
BTNOUT: IC2.9 ((CLKO/ICP3/INT7)PE7), R24.1, U11.7 (PB2(SCK/ADC1))
DL1: IC2.66 (PJ3(PCINT12)), U7.32 (PD2(INT0))
DL2: IC2.67 (PJ4(PCINT13)), U7.1 (PD3(INT1))
DL3: IC2.68 (PJ5(PCINT14)), U7.2 (PD4(XCK/T0))
DL4: IC2.69 (PJ6(PCINT15)), U7.9 (PD5(T1))
ETHCONECT: IC2.7 ((OC3C/INT5)PE5); also elsewhere on the board
GND: 3.3V.2, 5V.2, 12V.2, 13.C, C16.2, C17.2, C18.2, C19.2, C20.2, C27.2, D5.C, D6.C, D7.C, D8.C, IC2.11 (GND), IC2.32 (GND1), IC2.62 (GND2), IC2.81 (GND3), IC2.99 (AGND), ICSP.6, ISP2.6 (GND), J1.P$1 (1), J2.P$1 (1), J4.P$1 (1), JP6.2, JP6.4, JP7.3, JP9.2, OSS.2 (GND), OSS2.2 (GND), R24.2, R36.1, R44.2, S1.1 (S), S1.2 (S1), S4.3, S4.4 (P1), U7.3 (GND), U7.5 (AGND), U7.21 (GND), U8.5 (GND), U11.4 (GND), U47.1 (EN), U47.10 (GND), U49.1 (EN), U49.10 (GND); also elsewhere on the board
IN1: U47.9 (IN8); also elsewhere on the board
IN2: U47.8 (IN7); also elsewhere on the board
IN3: U47.7 (IN6); also elsewhere on the board
IN4: U47.6 (IN5); also elsewhere on the board
IN5: U47.5 (IN4); also elsewhere on the board
IN6: U47.4 (IN3); also elsewhere on the board
IN7: U47.3 (IN2); also elsewhere on the board
IN8: U47.2 (IN1); also elsewhere on the board
IN9: U49.2 (IN1); also elsewhere on the board
IN10: U49.3 (IN2); also elsewhere on the board
IN11: U49.4 (IN3); also elsewhere on the board
IN12: U49.5 (IN4); also elsewhere on the board
IO-1: IC2.35 (PL0(ICP4)); also elsewhere on the board
IO-2: IC2.36 (PL1(ICP5)); also elsewhere on the board
IO-3: IC2.37 (PL2(T5)); also elsewhere on the board
IO-4: IC2.38 (PL3(OC5A)); also elsewhere on the board
IO-5: IC2.39 (PL4(OC5B)); also elsewhere on the board
IO-6: IC2.40 (PL5(OC5C)); also elsewhere on the board
IO-7: IC2.41 (PL6); also elsewhere on the board
IO-8: IC2.42 (PL7); also elsewhere on the board
MISO-1: IC2.22 ((MISO/PCINT3)PB3), ICSP.1
MOSI-1: IC2.21 ((MOSI/PCINT2)PB2), ICSP.4
MPPWR: C16.1, C17.1, C18.1, C19.1, IC2.10 (VCC), IC2.31 (VCC1), IC2.61 (VCC2), IC2.80 (VCC3), IC2.100 (AVCC), ICSP.2, R26.2, U11.8 (VCC); also elsewhere on the board
unnamed: 13.A, R25.2
unnamed: D5.A, R11.2
unnamed: IC2.34 (XTAL1), OSS.3 (OUT)
unnamed: IC2.33 (XTAL2), OSS.1 (IN)
unnamed: IC2.92 ((ADC5/TMS)PF5), R35.1, R36.2
unnamed: D8.A, R10.2
unnamed: D6.A, R12.2
unnamed: IC2.63 (PJ0(RXD3/PCINT9)), J2.P$2 (2)
unnamed: IC2.64 (PJ1(TXD3/PCINT10)), J2.P$3 (3)
unnamed: D7.A, R39.2
unnamed: OSS2.3 (OUT), U7.8 (PB7(XTAL2/TOSC2))
unnamed: JP6.3, U11.6 (PB1(MISO))
unnamed: OSS2.1 (IN), U7.7 (PB6(XTAL1/TOSC1))
unnamed: J4.P$4 (4), U7.28 (PC5(ADC5/SCL))
unnamed: ISP2.4 (MOSI), U7.15 (PB3(MOSI/OC2))
unnamed: ISP2.1 (MISO), U7.16 (PB4(MISO))
unnamed: J4.P$3 (3), U7.27 (PC4(ADC4/SDA))
unnamed: C27.1, ISP2.2 (VCC), J4.P$2 (2), JP9.3, R27.2, U7.4 (VCC), U7.6 (VCC), U7.18 (AVCC)
unnamed: J1.P$3 (3), U8.6 (A)
unnamed: J1.P$2 (2), U8.7 (B)
unnamed: IC2.82 (PK7(ADC15/PCINT23)), U8.2 (RE/), U8.3 (DE)
O1: IC2.78 ((AD0)PA0), U47.12 (OUT8)
O2: IC2.77 ((AD1)PA1), U47.13 (OUT7)
O3: IC2.76 ((AD2)PA2), U47.14 (OUT6)
O4: IC2.75 ((AD3)PA3), U47.15 (OUT5)
O5: IC2.74 ((AD4)PA4), U47.16 (OUT4)
O6: IC2.73 ((AD5)PA5), U47.17 (OUT3)
O7: IC2.72 ((AD6)PA6), U47.18 (OUT2)
O8: IC2.71 ((AD7)PA7), U47.19 (OUT1)
O9: IC2.53 ((A8)PC0), U49.19 (OUT1)
O10: IC2.54 ((A9)PC1), U49.18 (OUT2)
O11: IC2.55 ((A10)PC2), U49.17 (OUT3)
O12: IC2.56 ((A11)PC3), U49.16 (OUT4)
PN13: IC2.26 ((OC0A/OC1C/PCINT7)PB7), R25.1
RESET: IC2.86 (PK3(ADC11/PCINT19)); also elsewhere on the board
RESET2: ISP2.5 (RST), R27.1, S4.1 (S), S4.2 (S1), U7.29 (PC6(/RESET))
RXD0: IC2.3 ((TXD0)PE1), JP7.1; also elsewhere on the board
RXD1: IC2.45 ((RXD1/INT2)PD2); also elsewhere on the board
RXD2: IC2.12 (PH0(RXD2)), U8.1 (RO)
SAT: U11.5 (PB0(MOSI)), U49.12 (OUT8)
SATIN: JP6.1, U49.9 (IN8)
SCK2: ISP2.3 (SCK), R39.1, U7.17 (PB5(SCK))
SCK-1: IC2.20 ((SCK/PCINT1)PB1), ICSP.3
SCL: IC2.43 ((SCL/INT0)PD0), JP3.1, R40.2; also elsewhere on the board
SDA: IC2.44 ((SDA/INT1)PD1), JP3.2, R41.2; also elsewhere on the board
ST: IC2.17 (PH5(OC4C)), JP4.1
TXD0: IC2.2 ((RXD0/PCIN8)PE0), JP7.2; also elsewhere on the board
TXD1: IC2.46 ((TXD1/INT3)PD3); also elsewhere on the board
TXD2: IC2.13 (PH1(TXD2)), U8.4 (DI)
WIFICONECT: IC2.8 ((T3/INT6)PE6); also elsewhere on the board

Notes on the sheet:
4.0
Control

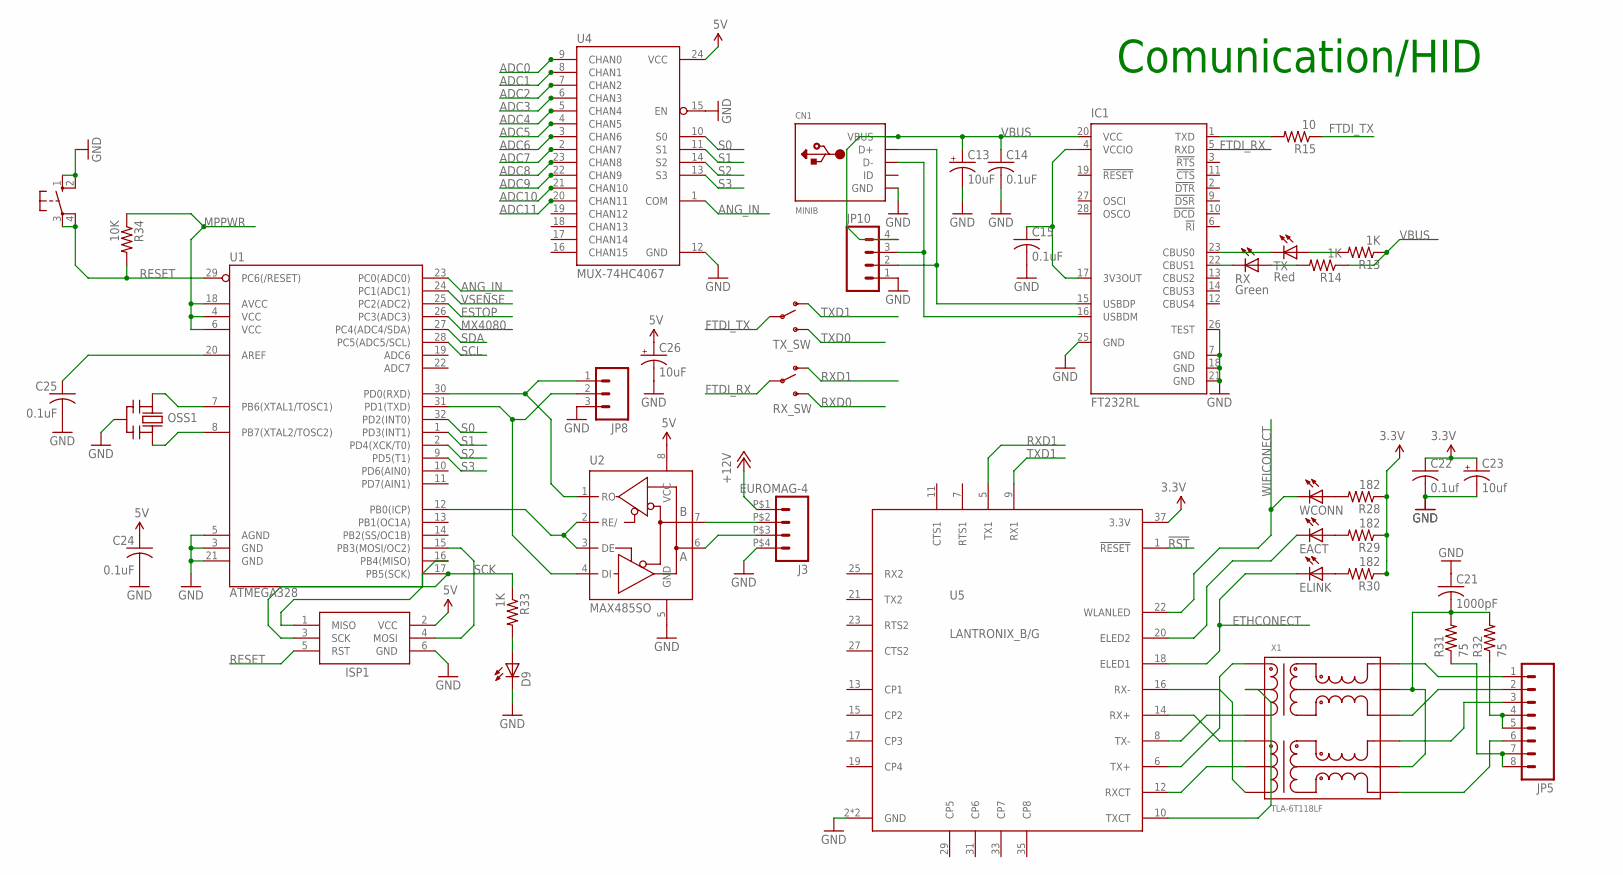
[picture p35: schematic Main board V4.0.sch, sheet 3]

Parts:
C13: 10uF; A/3216-18R
C14, C15, C24: 0.1uF; C0805K
C21: 1000pF; C1812
C22: 0.1uf; C0805K
C23: 10uf; EIA3528
C25: 0.1uF; C0805
C26: 10uF; EIA3528
CN1: MINIB; USB-MINIB
D9: LEDCHIP-LED0805; CHIP-LED0805
EACT: LEDCHIP-LED0805; CHIP-LED0805
ELINK: LEDCHIP-LED0805; CHIP-LED0805
IC1: FT232RL; SSOP28
ISP1: AVRISP-6; AVRISP
J3: EUROMAG-4; M4
JP5: M08LOCK_LONGPADS; 1X08_LOCK_LONGPADS
JP8: M03LOCK; 1X03_LOCK
JP10: M04LONGPADS; 1X04_LONGPADS
OSS1: CERMOSCILL-AWCSR; AWCSR
R13, R14, R33: 1K; R0805
R15: 10; R0805
R28, R29, R30: 182; R0805
R31, R32: 75; R0805
R34: 10K; R0805
RX: Green; CHIP-LED0805
RX_SW: SWITCH-SPSTKIT; SWITCH-SPDT_KIT
S3: 10-XX; B3F-10XX
TX: Red; CHIP-LED0805
TX_SW: SWITCH-SPSTKIT; SWITCH-SPDT_KIT
U1: ATMEGA328; TQFP32-08
U2: MAX485SO; SO08
U4: MUX-74HC4067; SSOP24
U5: LANTRONIX_B/G; LANA/BTH
WCONN: LEDCHIP-LED0805; CHIP-LED0805
X1: TLA-6T118LF; SO-16MOD

Connections:
3.3V: C22.1, C23.A (+), R28.1, R29.1, R30.1, U5.37 (3.3V); also elsewhere on the board
5V: C24.1, C26.A (+), ISP1.2 (VCC), U2.8 (VCC), U4.24 (VCC); also elsewhere on the board
!RST: U5.1 (!RESET); also elsewhere on the board
+12V: J3.P$1 (1); also elsewhere on the board
ADC0: U4.9 (CHAN0); also elsewhere on the board
ADC1: U4.8 (CHAN1); also elsewhere on the board
ADC2: U4.7 (CHAN2); also elsewhere on the board
ADC3: U4.6 (CHAN3); also elsewhere on the board
ADC4: U4.5 (CHAN4); also elsewhere on the board
ADC5: U4.4 (CHAN5); also elsewhere on the board
ADC6: U4.3 (CHAN6); also elsewhere on the board
ADC7: U4.2 (CHAN7); also elsewhere on the board
ADC8: U4.23 (CHAN8); also elsewhere on the board
ADC9: U4.22 (CHAN9); also elsewhere on the board
ADC10: U4.21 (CHAN10); also elsewhere on the board
ADC11: U4.20 (CHAN11); also elsewhere on the board
ANG_IN: U1.23 (PC0(ADC0)), U4.1 (COM)
ESTOP: U1.25 (PC2(ADC2)); also elsewhere on the board
ETHCONECT: ELINK.C, U5.18 (ELED1); also elsewhere on the board
FTDI_RX: IC1.5 (RXD), RX_SW.2
FTDI_TX: R15.1, TX_SW.2
GND: C13.-, C14.2, C15.2, C21.1, C22.2, C23.C (-), C24.2, C25.2, C26.C (-), CN1.GND, D9.C, IC1.7 (GND), IC1.18 (GND), IC1.21 (GND), IC1.25 (GND), IC1.26 (TEST), ISP1.6 (GND), J3.P$4 (4), JP8.3, JP10.1, OSS1.2 (GND), S3.1 (S), S3.2 (S1), U1.3 (GND), U1.5 (AGND), U1.21 (GND), U2.5 (GND), U4.12 (GND), U4.15 (EN), U5.2 (GND), U5.39 (GND); also elsewhere on the board
MPPWR: R34.1, U1.4 (VCC), U1.6 (VCC), U1.18 (AVCC); also elsewhere on the board
MX4080: U1.26 (PC3(ADC3)); also elsewhere on the board
unnamed: CN1.D+, IC1.15 (USBDP), JP10.2
unnamed: CN1.D-, IC1.16 (USBDM), JP10.3
unnamed: IC1.23 (CBUS0), TX.C
unnamed: D9.A, R33.2
unnamed: IC1.22 (CBUS1), RX.C
unnamed: R14.2, RX.A
unnamed: R13.2, TX.A
unnamed: IC1.1 (TXD), R15.2
unnamed: C15.1, IC1.4 (VCCIO), IC1.17 (3V3OUT)
unnamed: OSS1.3 (OUT), U1.8 (PB7(XTAL2/TOSC2))
unnamed: OSS1.1 (IN), U1.7 (PB6(XTAL1/TOSC1))
unnamed: C25.1, U1.20 (AREF)
unnamed: ISP1.4 (MOSI), U1.15 (PB3(MOSI/OC2))
unnamed: ISP1.1 (MISO), U1.16 (PB4(MISO))
unnamed: J3.P$2 (2), U2.7 (B)
unnamed: J3.P$3 (3), U2.6 (A)
unnamed: U1.12 (PB0(ICP)), U2.2 (RE/), U2.3 (DE)
unnamed: JP8.1, U1.30 (PD0(RXD)), U2.1 (RO)
unnamed: JP8.2, U1.31 (PD1(TXD)), U2.4 (DI)
unnamed: U5.8 (TX-), X1.3
unnamed: U5.6 (TX+), X1.1
unnamed: U5.14 (RX+), X1.6
unnamed: U5.16 (RX-), X1.8
unnamed: U5.12 (RXCT), X1.7
unnamed: U5.10 (TXCT), X1.2
unnamed: JP5.4, JP5.5, R32.1
unnamed: JP5.7, JP5.8, R31.1
unnamed: JP5.6, X1.9
unnamed: JP5.3, X1.11
unnamed: JP5.2, X1.14
unnamed: JP5.1, X1.16
unnamed: C21.2, R31.2, R32.2, X1.10, X1.15
unnamed: ELINK.A, R30.2
unnamed: EACT.A, R29.2
unnamed: R28.2, WCONN.A
unnamed: EACT.C, U5.20 (ELED2)
RESET: ISP1.5 (RST), R34.2, S3.3, S3.4 (P1), U1.29 (PC6(/RESET)); also elsewhere on the board
RXD0: RX_SW.3 (S); also elsewhere on the board
RXD1: RX_SW.1 (O), U5.5 (TX1); also elsewhere on the board
S0: U1.32 (PD2(INT0)), U4.10 (S0)
S1: U1.1 (PD3(INT1)), U4.11 (S1)
S2: U1.2 (PD4(XCK/T0)), U4.14 (S2)
S3: U1.9 (PD5(T1)), U4.13 (S3)
SCK: ISP1.3 (SCK), R33.1, U1.17 (PB5(SCK))
SCL: U1.28 (PC5(ADC5/SCL)); also elsewhere on the board
SDA: U1.27 (PC4(ADC4/SDA)); also elsewhere on the board
TXD0: TX_SW.3 (S); also elsewhere on the board
TXD1: TX_SW.1 (O), U5.9 (RX1); also elsewhere on the board
VBUS: C13.+, C14.1, CN1.VBUS, IC1.20 (VCC), JP10.4, R13.1, R14.1
VSENSE: U1.24 (PC1(ADC1)); also elsewhere on the board
WIFICONECT: U5.22 (WLANLED), WCONN.C; also elsewhere on the board

Notes on the sheet:
Comunication/HID

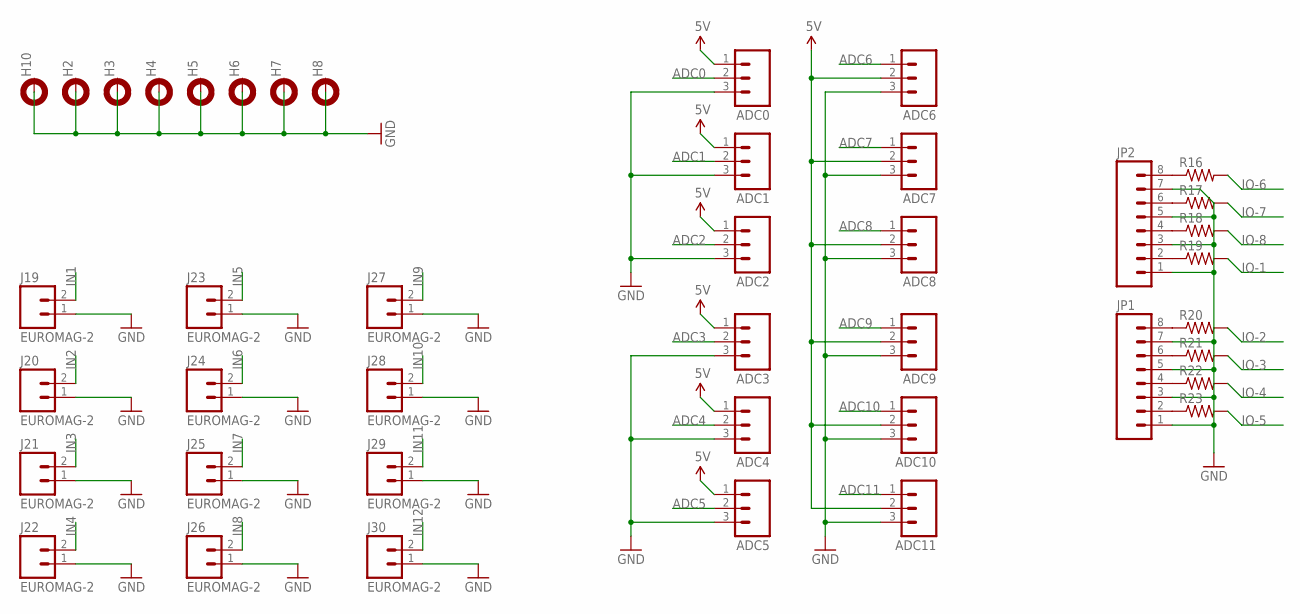
[picture p36: schematic Main board V4.0.sch, sheet 4]

Parts:
ADC0, ADC1, ADC2, ADC3, ADC4, ADC5: EUROMAG-390DEG; M3
ADC6, ADC7, ADC8, ADC9, ADC10, ADC11: M03PTH; 1X03
H2, H3, H4, H5, H6, H7, H8, H10: MOUNT-PAD-ROUND2.8; 2,8-PAD
J19, J20, J21, J22, J23, J24, J25, J26, J27, J28, J29, J30: EUROMAG-2; M2
JP1, JP2: M08LOCK; 1X08_LOCK
R16, R17, R18, R19, R20, R21, R22, R23: R-US_FLIPFLOP; 0805-THM

Connections:
5V: ADC0.1, ADC1.1, ADC2.1, ADC3.1, ADC4.1, ADC5.1, ADC6.2, ADC7.2, ADC8.2, ADC9.2, ADC10.2, ADC11.2; also elsewhere on the board
ADC0: ADC0.2; also elsewhere on the board
ADC1: ADC1.2; also elsewhere on the board
ADC2: ADC2.2; also elsewhere on the board
ADC3: ADC3.2; also elsewhere on the board
ADC4: ADC4.2; also elsewhere on the board
ADC5: ADC5.2; also elsewhere on the board
ADC6: ADC6.1; also elsewhere on the board
ADC7: ADC7.1; also elsewhere on the board
ADC8: ADC8.1; also elsewhere on the board
ADC9: ADC9.1; also elsewhere on the board
ADC10: ADC10.1; also elsewhere on the board
ADC11: ADC11.1; also elsewhere on the board
GND: ADC0.3, ADC1.3, ADC2.3, ADC3.3, ADC4.3, ADC5.3, ADC6.3, ADC7.3, ADC8.3, ADC9.3, ADC10.3, ADC11.3, H2.B2,8, H3.B2,8, H4.B2,8, H5.B2,8, H6.B2,8, H7.B2,8, H8.B2,8, H10.B2,8, J19.1, J20.1, J21.1, J22.1, J23.1, J24.1, J25.1, J26.1, J27.1, J28.1, J29.1, J30.1, JP1.1, JP1.3, JP1.5, JP1.7, JP2.1, JP2.3, JP2.5, JP2.7; also elsewhere on the board
IN1: J19.2; also elsewhere on the board
IN2: J20.2; also elsewhere on the board
IN3: J21.2; also elsewhere on the board
IN4: J22.2; also elsewhere on the board
IN5: J23.2; also elsewhere on the board
IN6: J24.2; also elsewhere on the board
IN7: J25.2; also elsewhere on the board
IN8: J26.2; also elsewhere on the board
IN9: J27.2; also elsewhere on the board
IN10: J28.2; also elsewhere on the board
IN11: J29.2; also elsewhere on the board
IN12: J30.2; also elsewhere on the board
IO-1: R19.2; also elsewhere on the board
IO-2: R20.2; also elsewhere on the board
IO-3: R21.2; also elsewhere on the board
IO-4: R22.2; also elsewhere on the board
IO-5: R23.2; also elsewhere on the board
IO-6: R16.2; also elsewhere on the board
IO-7: R17.2; also elsewhere on the board
IO-8: R18.2; also elsewhere on the board
unnamed: JP1.8, R20.1
unnamed: JP1.6, R21.1
unnamed: JP1.4, R22.1
unnamed: JP1.2, R23.1
unnamed: JP2.2, R19.1
unnamed: JP2.4, R18.1
unnamed: JP2.6, R17.1
unnamed: JP2.8, R16.1
