UA-Robotics/UA-NASA-Robotic-Mining-2012-Hardware/Main Board V4.0/Main board V4.0.brd

## EAGLE design Main Board V4.0/Main board V4.0.brd (continued)

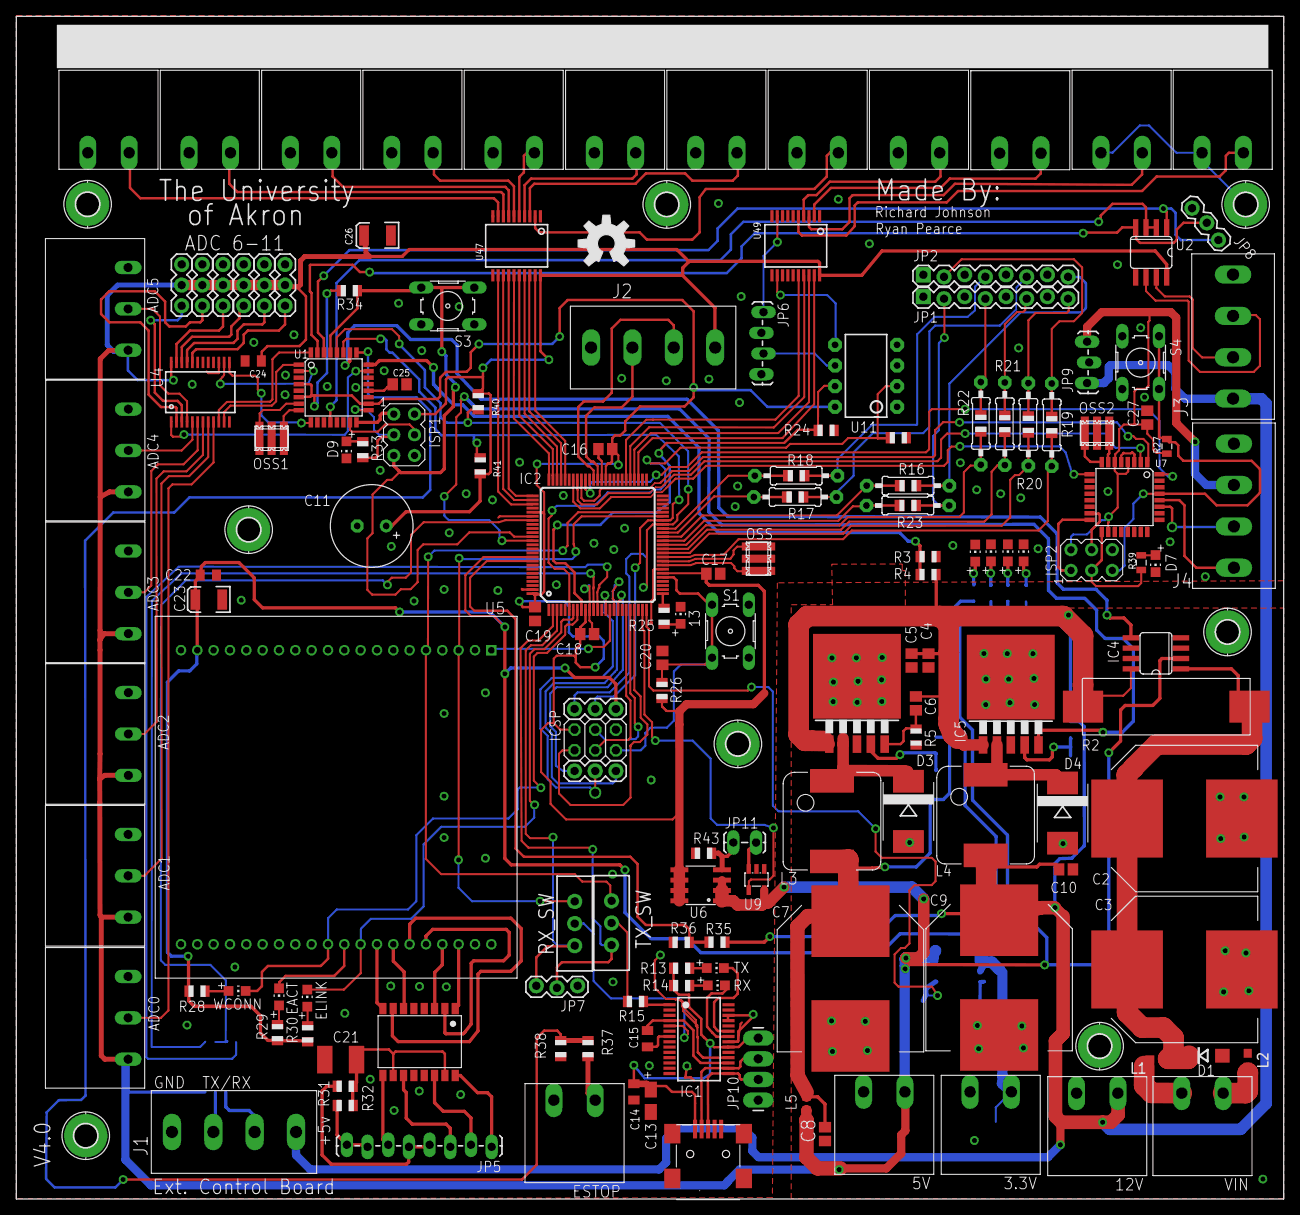
[picture p37: board Main board V4.0.brd from above]

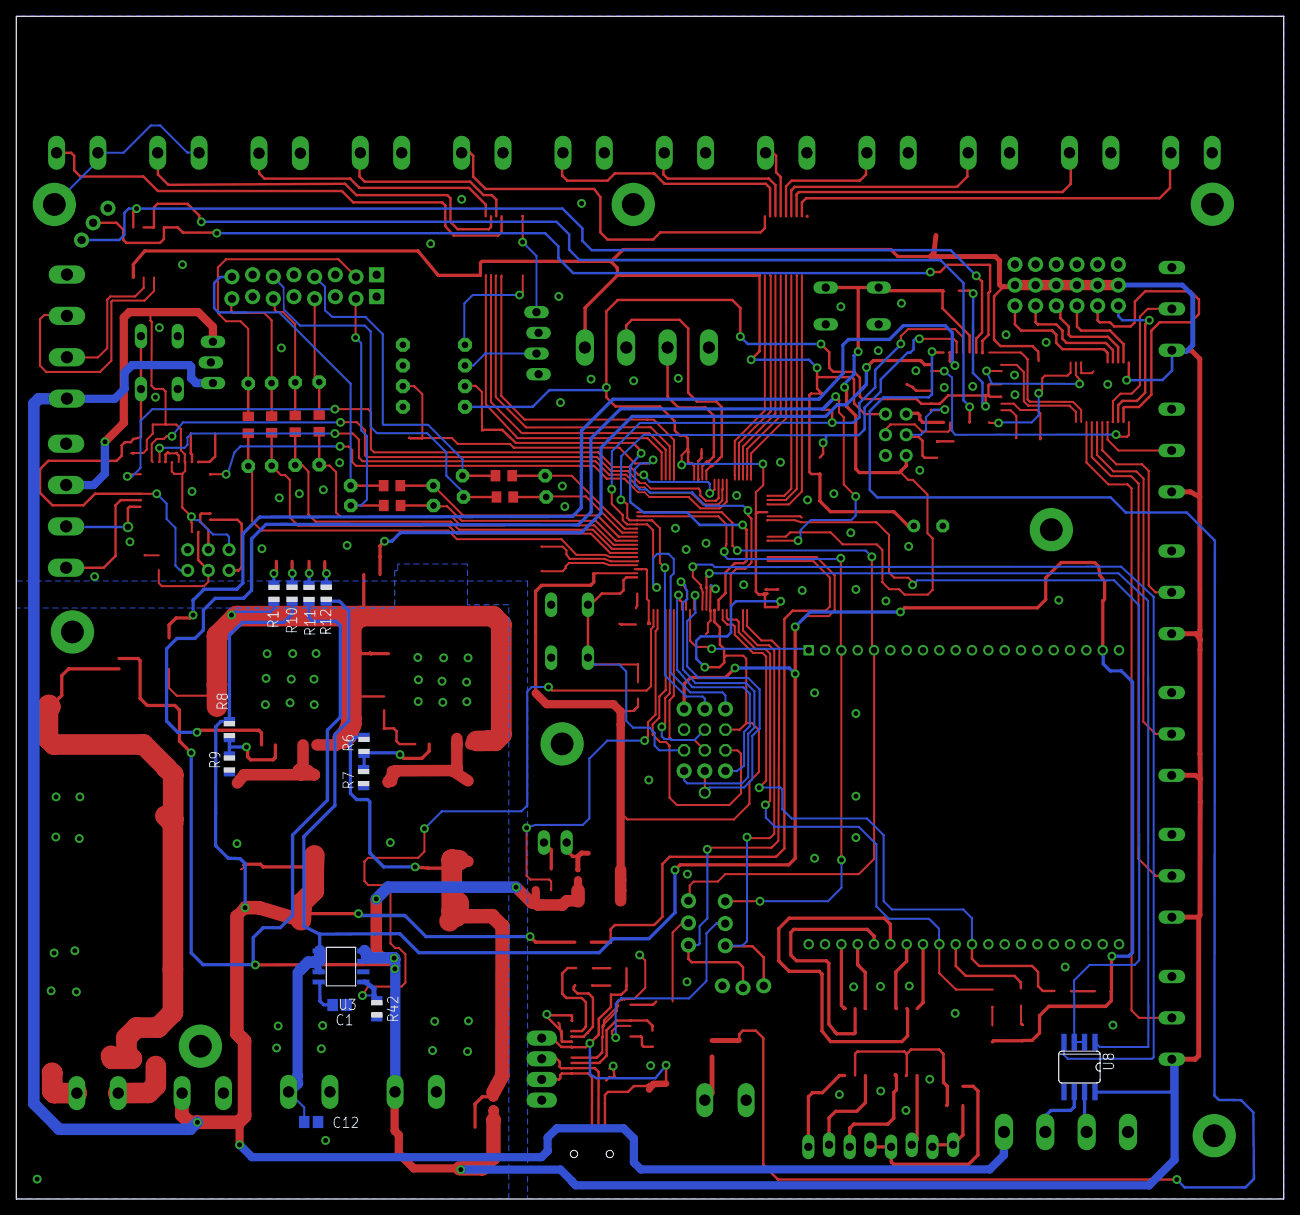
[picture p38: board Main board V4.0.brd from below]

Board: 2 copper layers, 155.7 x 145.3 mm, 174 parts (13 on the bottom side), 174 nets.
