UA-Robotics/UA-NASA-Robotic-Mining-2012-Hardware/LIDAR/xv11_lidar_controller.brd

## EAGLE design LIDAR/xv11_lidar_controller.brd (2015-08-14)

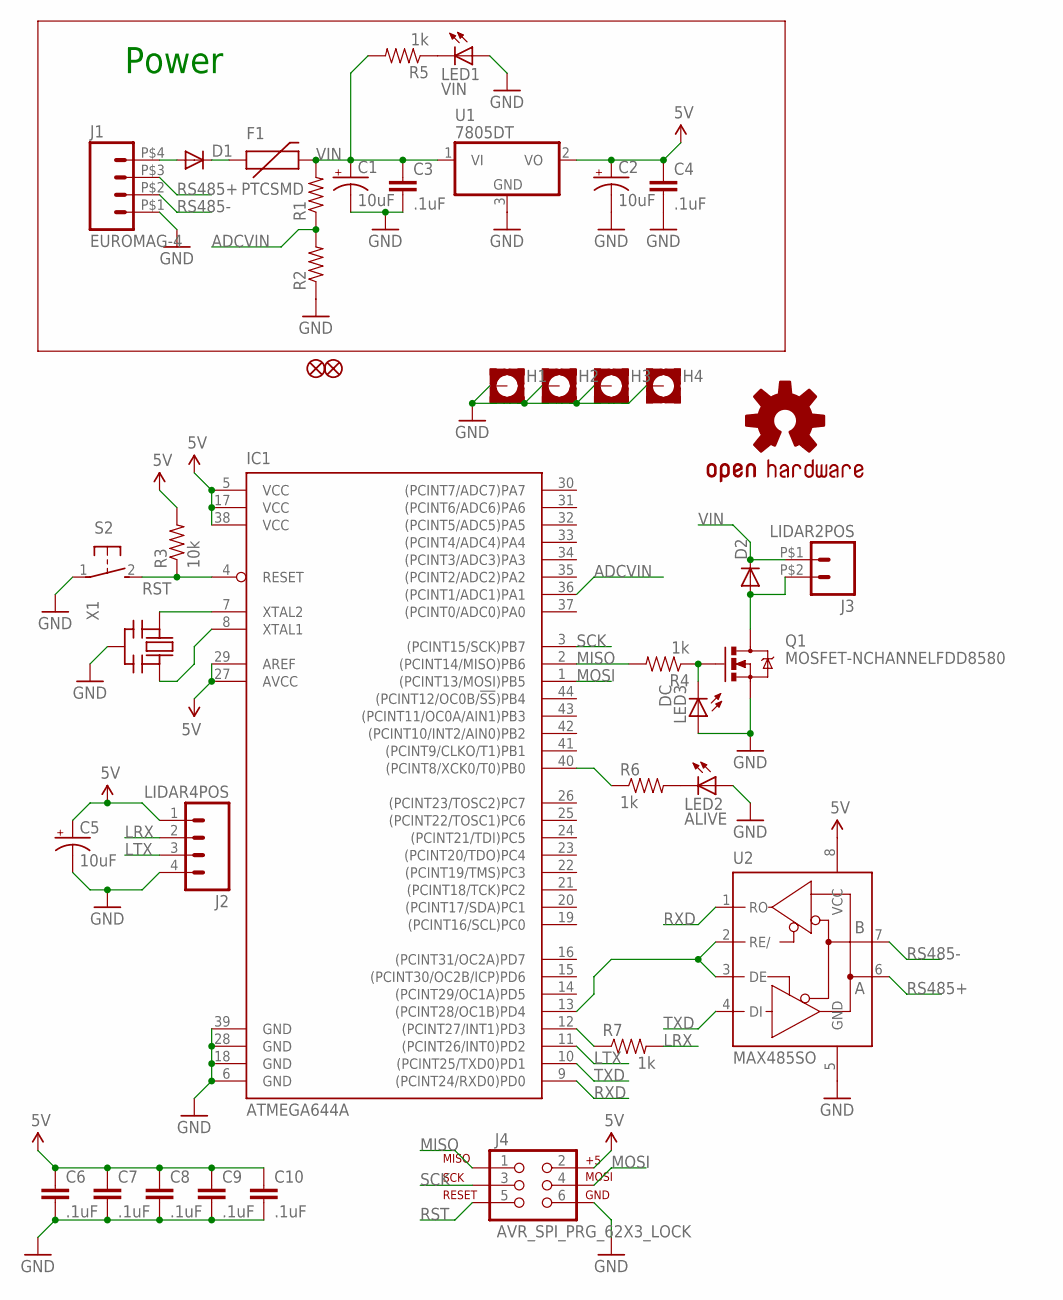
[picture p39: schematic xv11_lidar_controller.sch]

Parts:
C1: 10uF; EIA6032
C2, C5: 10uF; EIA3216-KIT
C3, C4, C6, C7, C8, C9, C10: .1uF; 0805
D1, D2: DIODESMA; SMA-DIODE
F1: PTCSMD; PTC-1206
H1, H2, H3, H4: MOUNT-PAD-SQUARE5.5; 5,5-PAD-SQUARE
IC1: ATMEGA644A; TQFP44
J1: EUROMAG-4; M4
J2: LIDAR4POS; 2MM4POS
J3: LIDAR2POS; 2MM2POS
J4: AVR_SPI_PRG_62X3_LOCK; 2X3_LOCK
JP1, JP2: FIDUCIAL1.5X3; FIDUCIAL-1.5X3
LED1: VIN; LED-0603
LED2: ALIVE; LED-0603
LED3: DC; LED-0603
Q1: MOSFET-NCHANNELFDD8580; DPAK
R1, R2: RESISTOR0805-RES; 0805
R3: 10k; 0805
R4, R5, R6, R7: 1k; 0805
S2: 31-XX; B3F-31XX
U1: 7805DT; TO252
U2: MAX485SO; SO08
U$2: OSHW-LOGOL; OSHW-LOGO-L
X1: CERMOSCILL-AWCSR; AWCSR

Connections:
5V: C2.A (+), C4.1, C5.A (+), C6.1, C7.1, C8.1, C9.1, C10.1, IC1.5 (VCC), IC1.17 (VCC), IC1.27 (AVCC), IC1.29 (AREF), IC1.38 (VCC), J2.1, J4.2, R3.2, U1.2 (VO), U2.8 (VCC)
ADCVIN: IC1.36 ((PCINT1/ADC1)PA1), R1.1, R2.2
GND: C1.P$2 (-), C2.C (-), C3.2, C4.2, C5.C (-), C6.2, C7.2, C8.2, C9.2, C10.2, H1.B5,5, H2.B5,5, H3.B5,5, H4.B5,5, IC1.6 (GND), IC1.18 (GND), IC1.28 (GND), IC1.39 (GND), J1.P$1 (1), J2.4, J4.6, LED1.A, LED2.A, LED3.A, Q1.3 (S), R2.1, S2.1, U1.3 (GND), U2.5 (GND), X1.2 (GND)
LRX: J2.2, R7.2
LTX: IC1.11 ((PCINT26/INT0)PD2), J2.3
MISO: IC1.2 ((PCINT14/MISO)PB6), J4.1, R4.2
MOSI: IC1.1 ((PCINT13/MOSI)PB5), J4.4
unnamed: D1.A, J1.P$4 (4)
unnamed: D1.C, F1.1
unnamed: LED3.C, Q1.1 (G), R4.1
unnamed: LED1.C, R5.1
unnamed: IC1.40 ((PCINT8/XCK0/T0)PB0), R6.1
unnamed: LED2.C, R6.2
unnamed: D2.A, J3.P$2 (2), Q1.4 (D)
unnamed: IC1.13 ((PCINT28/OC1B)PD4), U2.2 (RE/), U2.3 (DE)
unnamed: IC1.12 ((PCINT27/INT1)PD3), R7.1
unnamed: IC1.7 (XTAL2), X1.1 (IN)
unnamed: IC1.8 (XTAL1), X1.3 (OUT)
RS485+: J1.P$3 (3), U2.6 (A)
RS485-: J1.P$2 (2), U2.7 (B)
RST: IC1.4 (RESET), J4.5, R3.1, S2.2 (S)
RXD: IC1.9 ((PCINT24/RXD0)PD0), U2.1 (RO)
SCK: IC1.3 ((PCINT15/SCK)PB7), J4.3
TXD: IC1.10 ((PCINT25/TXD0)PD1), U2.4 (DI)
VIN: C1.P$1 (+), C3.1, D2.C, F1.2, J3.P$1 (1), R1.2, R5.2, U1.1 (VI)

Notes on the sheet:
Power

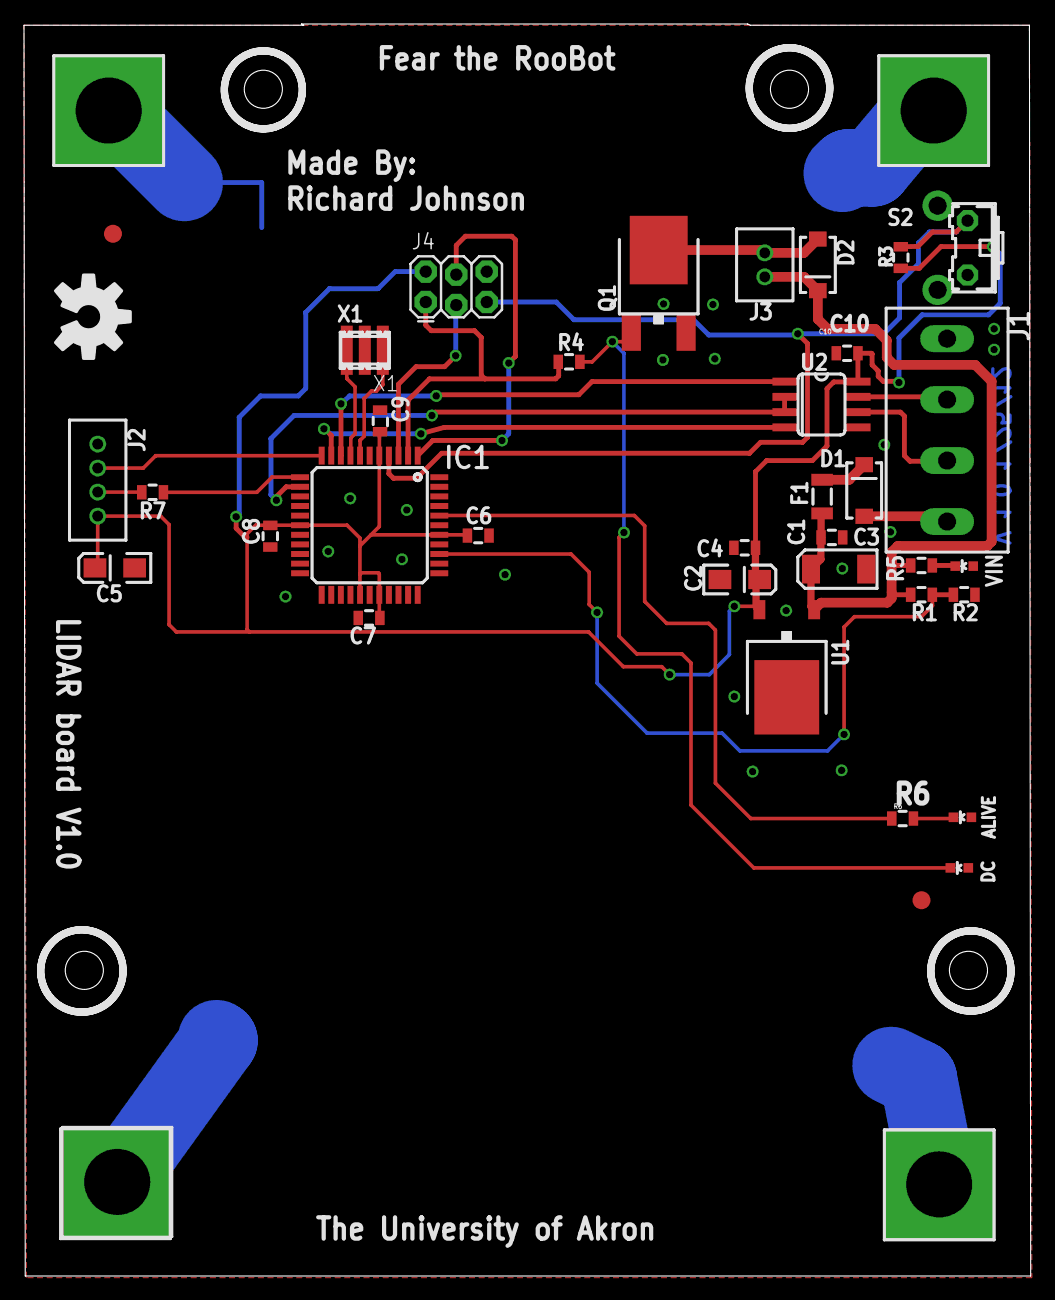
[picture p40: board xv11_lidar_controller.brd from above]

Board: 2 copper layers, 83.9 x 104.3 mm, 40 parts (0 on the bottom side), 25 nets.
